nnscr/Mendel90/dibond/sheets/y_carriage.dxf

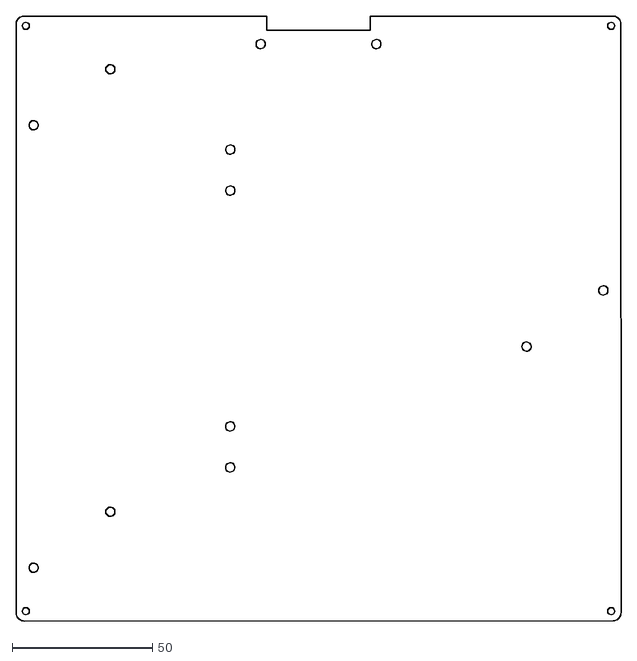
[picture p1: CAD file, 2015-10-09]
dibond/sheets/y_carriage.dxf
216.0 x 216.0
