nnscr/Mendel90/dibond/stls/printed/y_bearing_mounts.stl

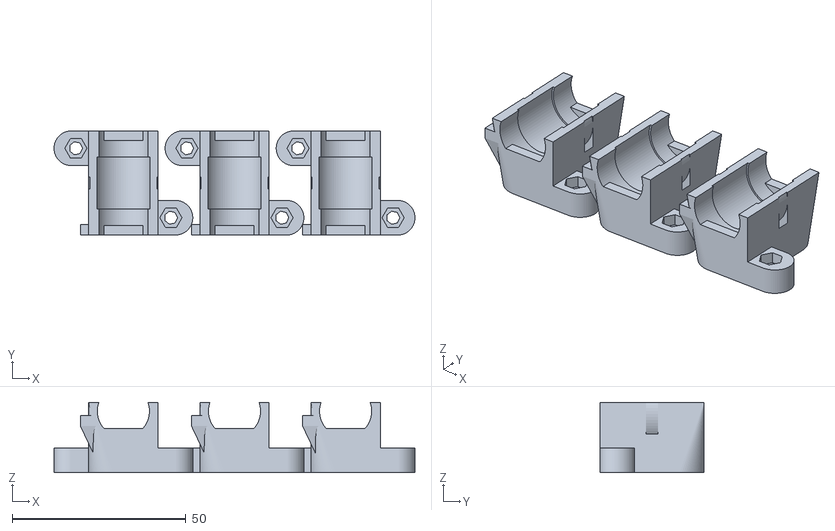
[picture p2: CAD file, 2015-10-09]
dibond/stls/printed/y_bearing_mounts.stl
104.0 x 30.0 x 20.2
