nnscr/Mendel90/dibond/stls/spool_bracket_female.stl

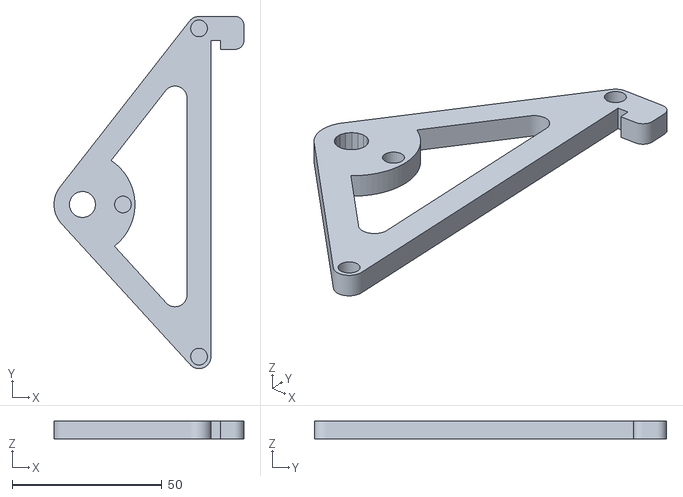
[picture p3: CAD file, 2015-10-09]
dibond/stls/spool_bracket_female.stl
63.4 x 117.5 x 6.00
