nnscr/Mendel90/imported_stls/E3D_v6_1.75mm_Universal.stl

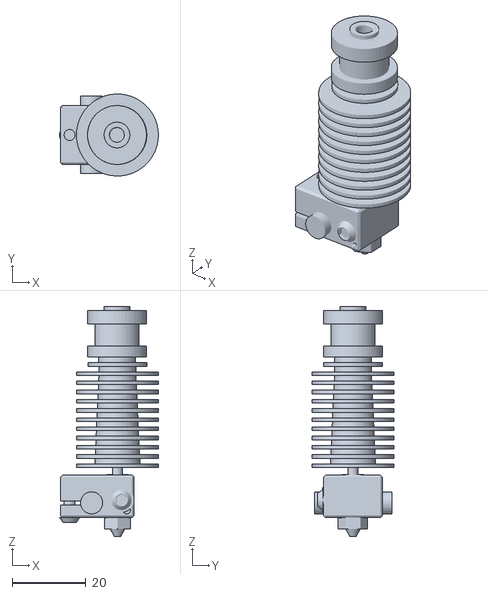
[picture p4: CAD file, 2015-10-11]
imported_stls/E3D_v6_1.75mm_Universal.stl
26.9 x 22.3 x 62.5
