nnscr/Mendel90/mendel/stls/printed/x_carriage_parts.stl

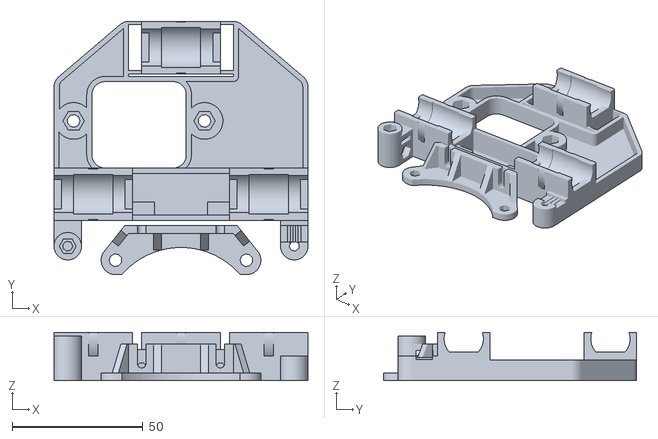
[picture p5: CAD file, 2015-10-09]
mendel/stls/printed/x_carriage_parts.stl
97.0 x 96.7 x 18.5
