nnscr/Mendel90/mendel/stls/ribbon_clamp_14_33NB.stl

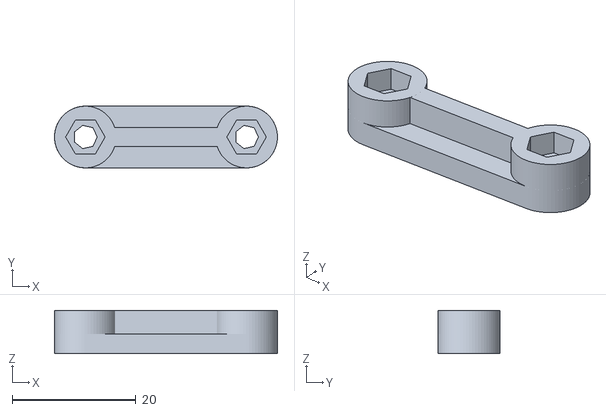
[picture p6: CAD file, 2015-10-09]
mendel/stls/ribbon_clamp_14_33NB.stl
36.1 x 10.00 x 7.01
