nnscr/Mendel90/nnscr/#frame_stays.dxf

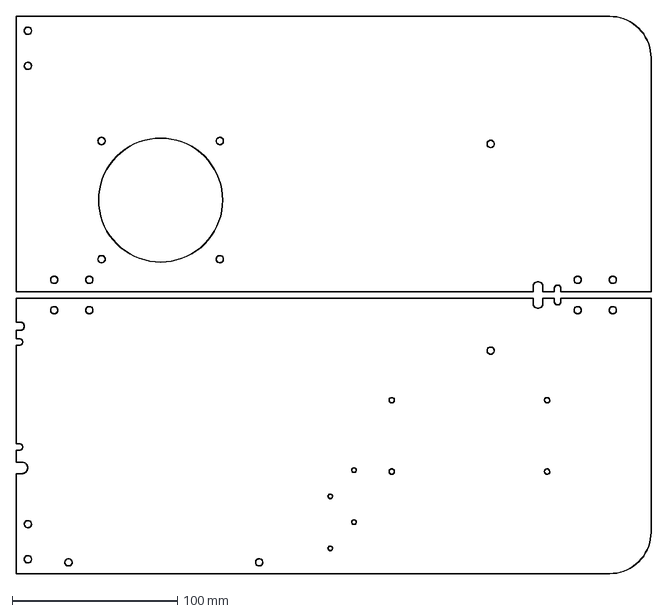
[picture p7: CAD file, 2015-10-09]
nnscr/#frame_stays.dxf
384.0 x 337.0 mm
