nnscr/Mendel90/nnscr/sheets/frame_gantry_and_y_carriage.dxf

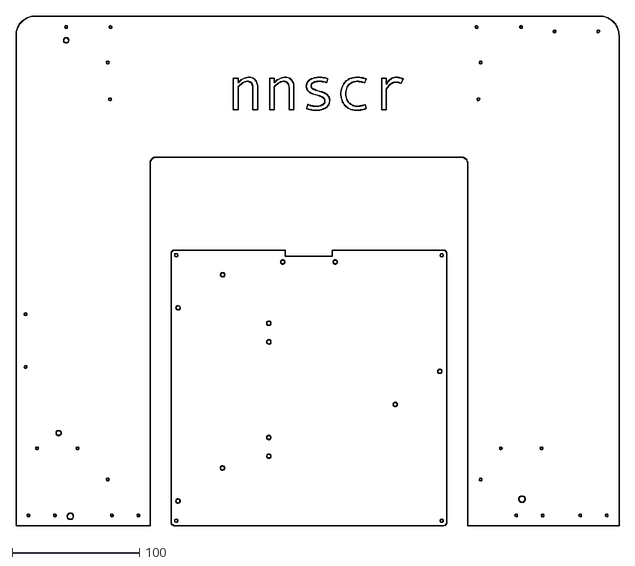
[picture p8: CAD file, 2015-10-26]
nnscr/sheets/frame_gantry_and_y_carriage.dxf
474.5 x 401.0
