nnscr/Mendel90/nnscr/stls/atx_short_bracket.stl

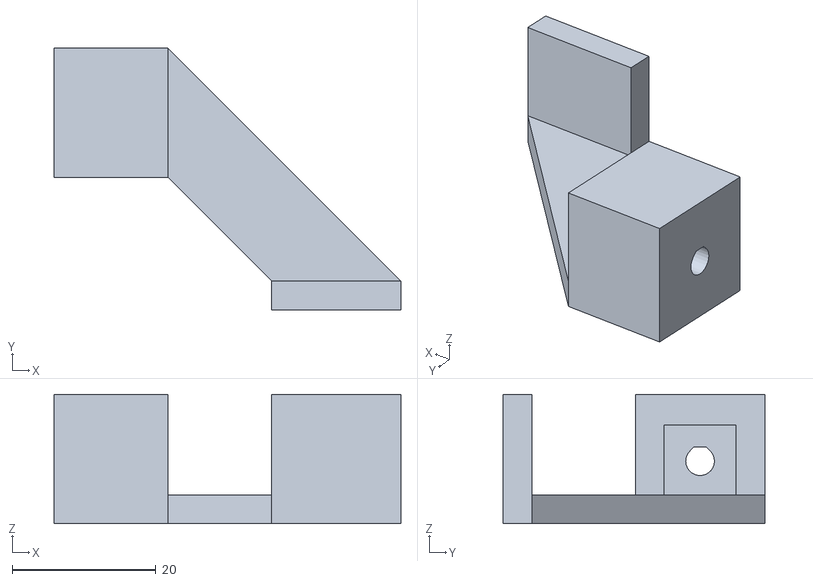
[picture p9: CAD file, 2015-10-26]
nnscr/stls/atx_short_bracket.stl
48.3 x 36.4 x 18.0
