nnscr/Mendel90/nnscr/stls/printed/wades_extruder.stl

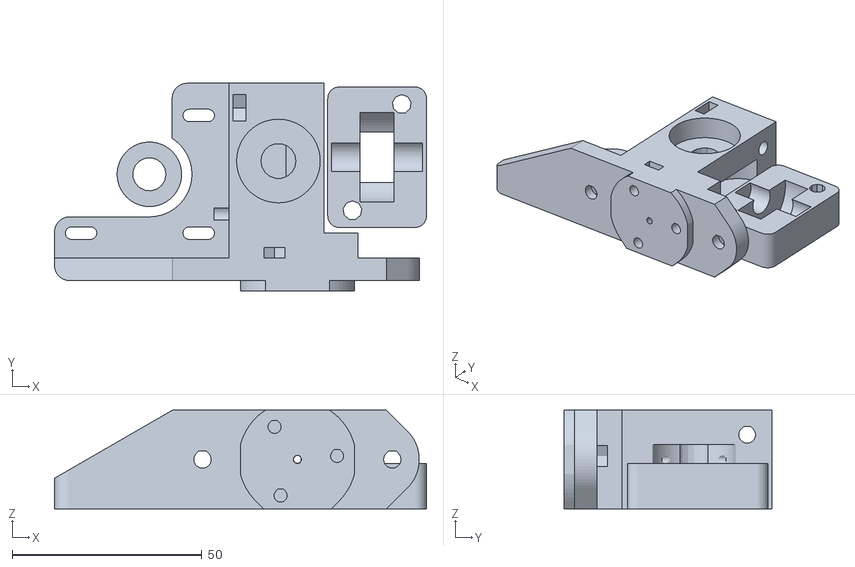
[picture p10: CAD file, 2015-10-26]
nnscr/stls/printed/wades_extruder.stl
98.0 x 54.7 x 26.0
