nnscr/Mendel90/dibond/sheets/y_heatshield.dxf

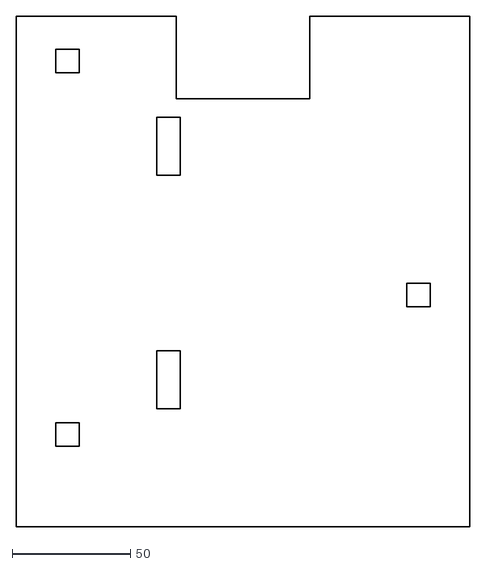
[picture p11: CAD file, 2015-10-09]
dibond/sheets/y_heatshield.dxf
192.0 x 216.0
