nnscr/Mendel90/dibond/stls/y_bearing_mount.stl

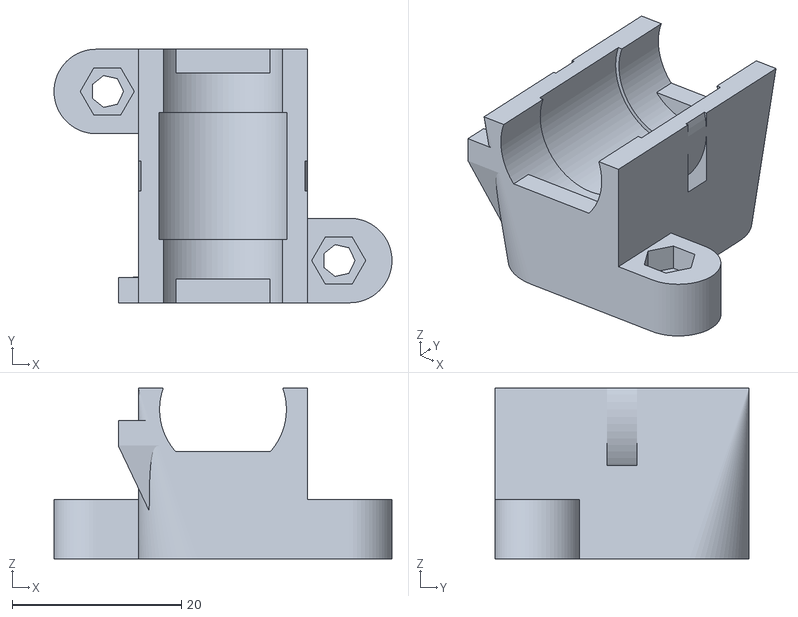
[picture p12: CAD file, 2015-10-09]
dibond/stls/y_bearing_mount.stl
40.0 x 30.0 x 20.2
