nnscr/Mendel90/imported_stls/e3d_v6_fan_duct.stl

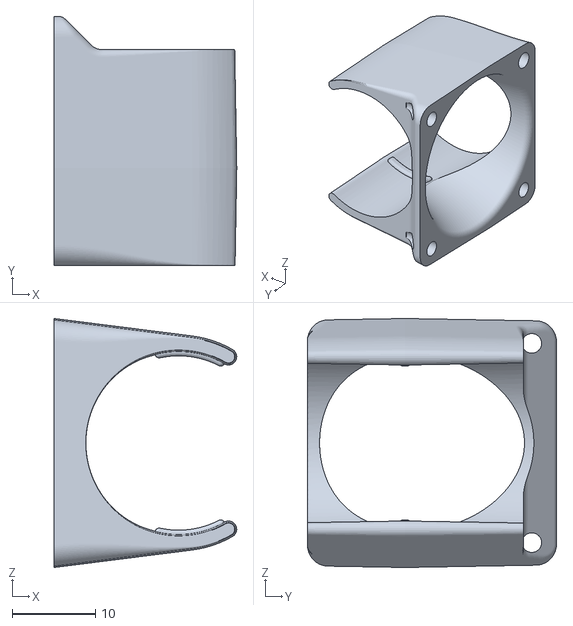
[picture p13: CAD file, 2015-10-09]
imported_stls/e3d_v6_fan_duct.stl
22.0 x 30.0 x 30.0
