nnscr/Mendel90/mendel/stls/d_shell.stl

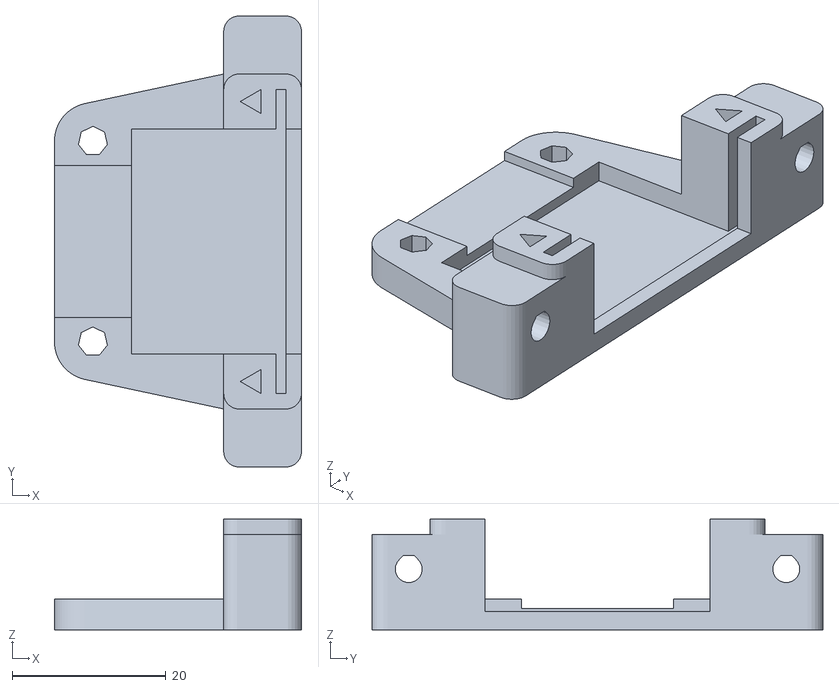
[picture p14: CAD file, 2015-10-09]
mendel/stls/d_shell.stl
32.1 x 58.6 x 14.4
