nnscr/Mendel90/mendel/stls/printed/spool_holder_brackets.stl

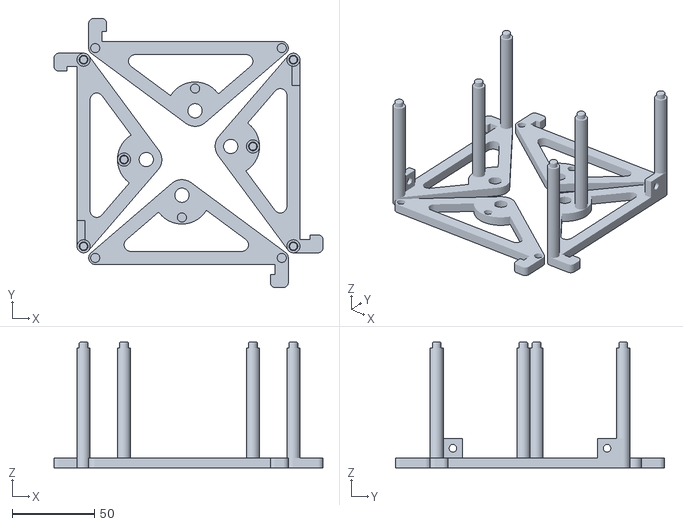
[picture p15: CAD file, 2015-10-09]
mendel/stls/printed/spool_holder_brackets.stl
163.6 x 163.6 x 76.4
