nnscr/Mendel90/nnscr/sheets/frame_stays.dxf

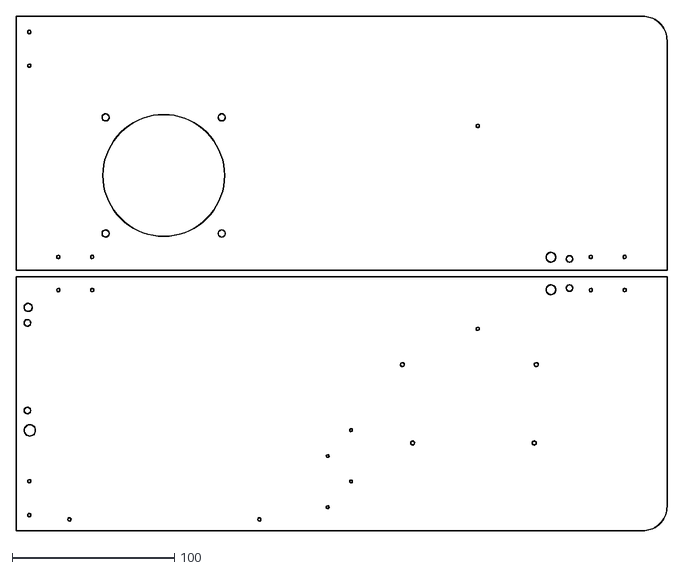
[picture p16: CAD file, 2015-10-26]
nnscr/sheets/frame_stays.dxf
401.0 x 317.0
