nnscr/Mendel90/nnscr/stls/printed/atx_brackets.stl

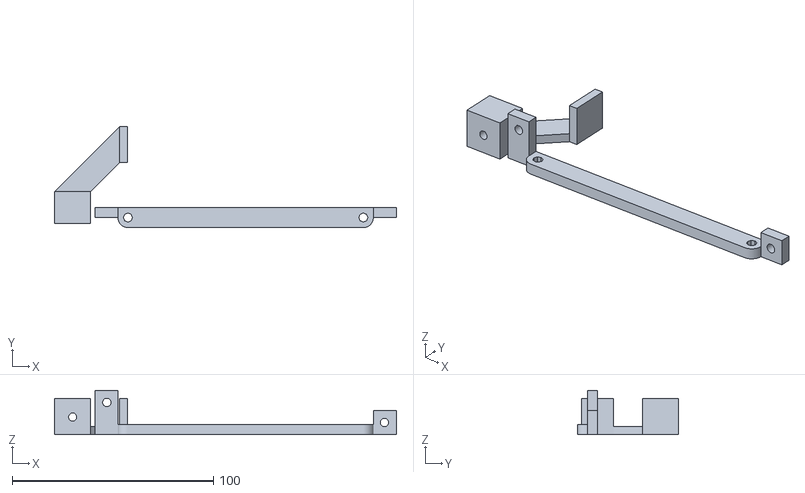
[picture p17: CAD file, 2015-10-26]
nnscr/stls/printed/atx_brackets.stl
170.0 x 50.3 x 22.0
