nnscr/Mendel90/nnscr/stls/wades_block.stl

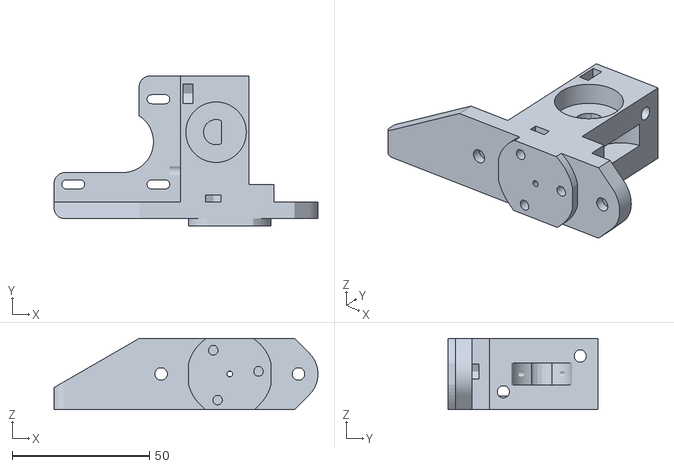
[picture p18: CAD file, 2015-10-26]
nnscr/stls/wades_block.stl
96.1 x 54.7 x 26.0
