nnscr/Mendel90/dibond/sheets/frame_right.dxf

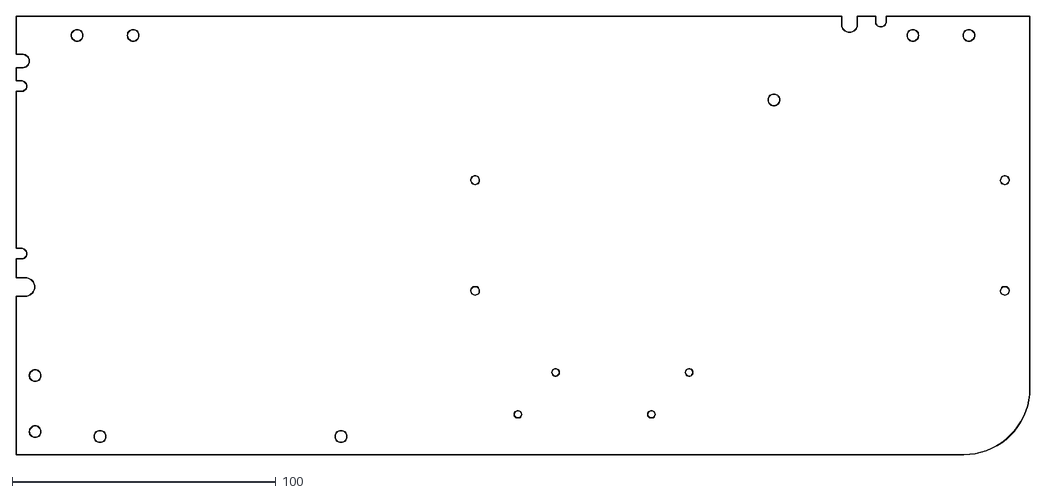
[picture p19: CAD file, 2015-10-09]
dibond/sheets/frame_right.dxf
384.0 x 166.0
