nnscr/Mendel90/dibond/stls/printed/atx_brackets.stl

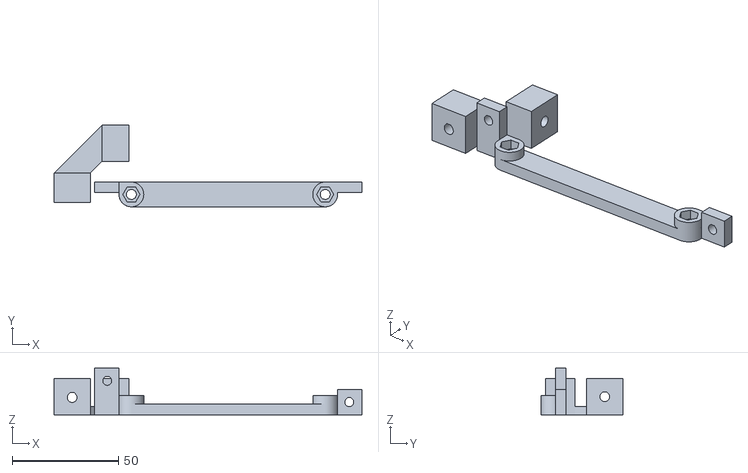
[picture p20: CAD file, 2015-10-09]
dibond/stls/printed/atx_brackets.stl
145.1 x 38.5 x 22.0
