nnscr/Mendel90/mendel/stls/printed/z_motor_brackets.stl

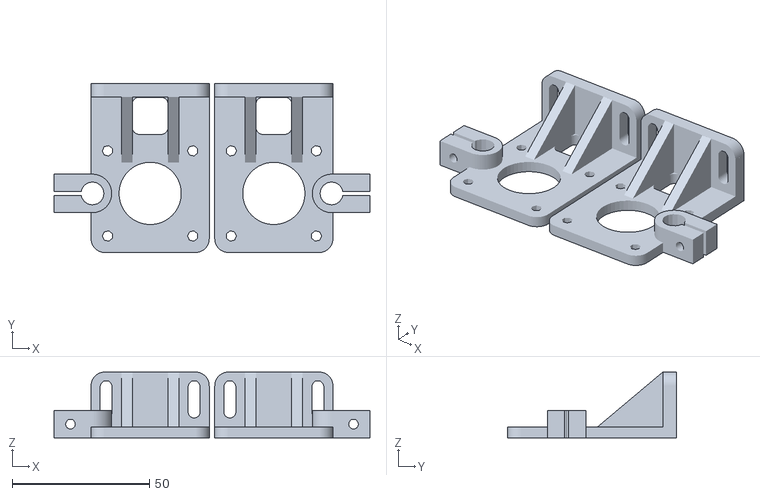
[picture p22: CAD file, 2015-10-09]
mendel/stls/printed/z_motor_brackets.stl
115.0 x 61.5 x 24.0
