nnscr/Mendel90/mendel/stls/ribbon_clamp_26_44.stl

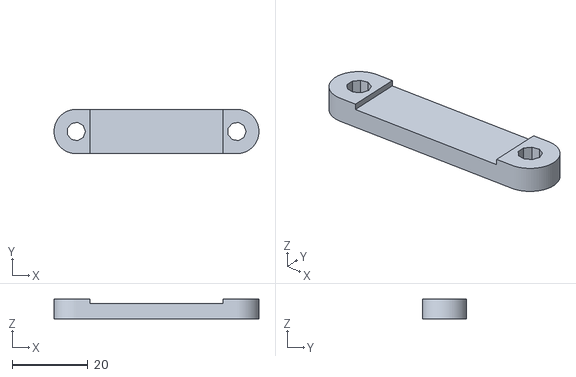
[picture p23: CAD file, 2015-10-09]
mendel/stls/ribbon_clamp_26_44.stl
54.1 x 11.7 x 5.20
