nnscr/Mendel90/nnscr/sheets/frame_base.dxf

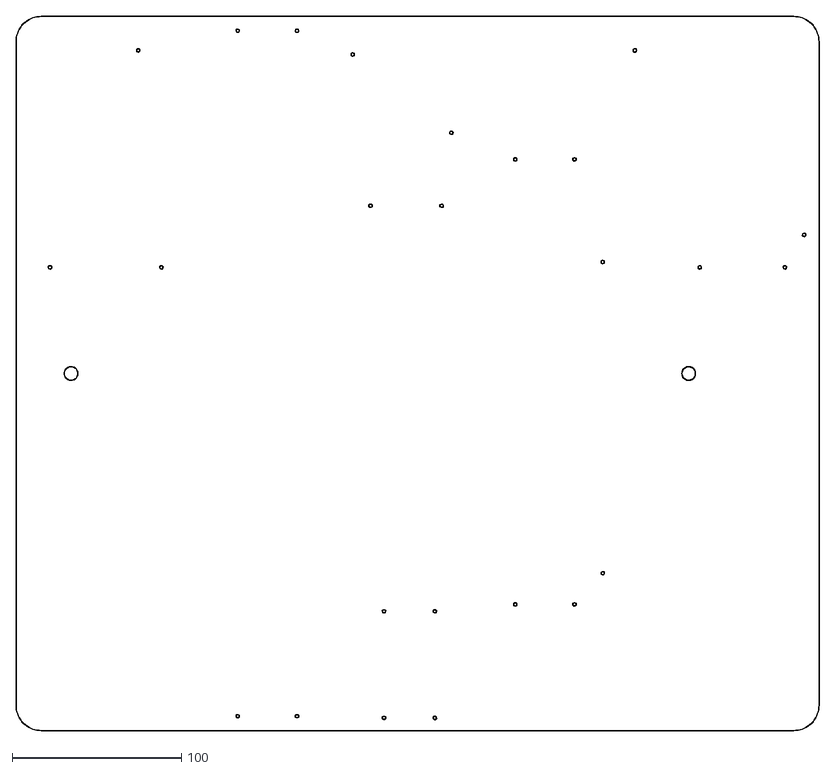
[picture p24: CAD file, 2015-10-26]
nnscr/sheets/frame_base.dxf
474.5 x 422.0
