nnscr/Mendel90/nnscr/stls/printed/spool_holder_brackets.stl

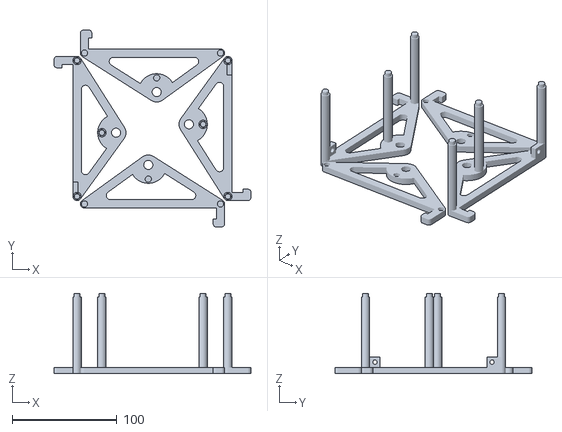
[picture p25: CAD file, 2015-10-26]
nnscr/stls/printed/spool_holder_brackets.stl
187.6 x 187.6 x 76.5
