nnscr/Mendel90/nnscr/stls/y_idler_bracket.stl

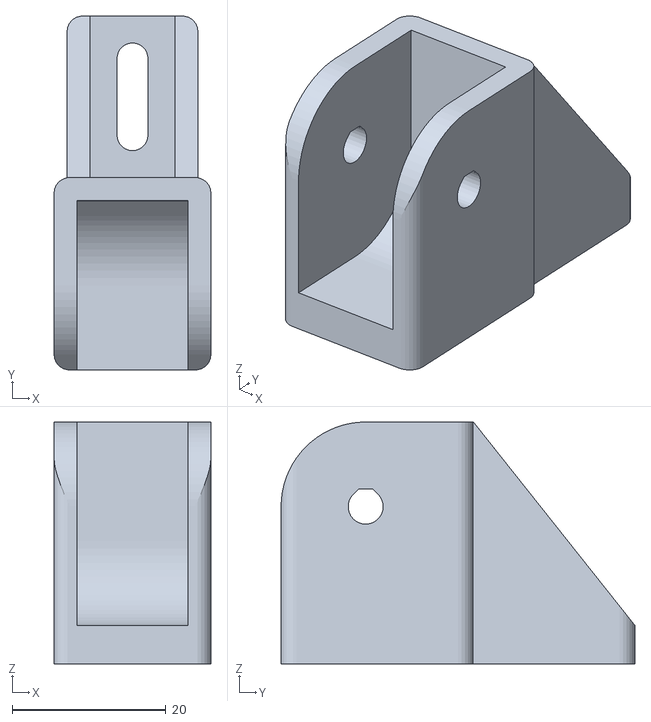
[picture p26: CAD file, 2015-10-19]
nnscr/stls/y_idler_bracket.stl
20.4 x 46.0 x 31.4
