nnscr/Mendel90/dibond/sheets/frame_gantry_and_y_carriage.dxf

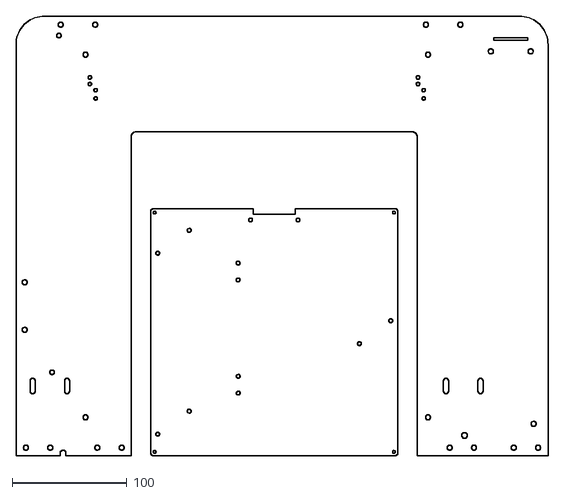
[picture p27: CAD file, 2015-10-09]
dibond/sheets/frame_gantry_and_y_carriage.dxf
464.5 x 384.0
