nnscr/Mendel90/dibond/stls/x_end_clamp.stl

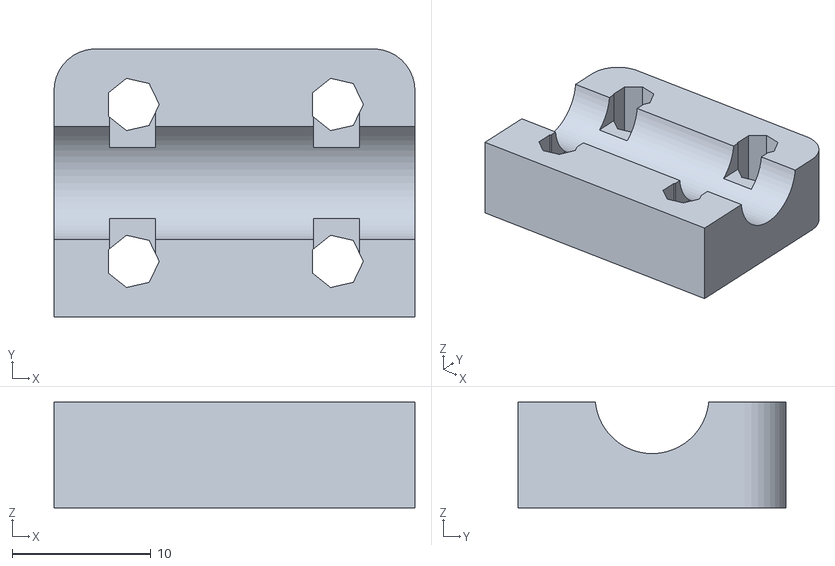
[picture p29: CAD file, 2015-10-09]
dibond/stls/x_end_clamp.stl
26.0 x 19.3 x 7.60
