nnscr/Mendel90/mendel/stls/printed/x_idler_bracket.stl

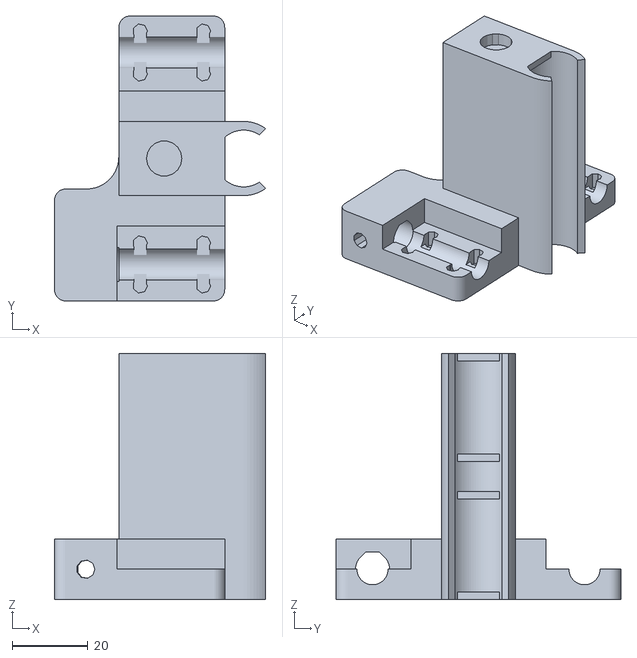
[picture p30: CAD file, 2015-10-09]
mendel/stls/printed/x_idler_bracket.stl
55.8 x 75.3 x 65.0
