nnscr/Mendel90/mendel/stls/y_belt_clip_toothed.stl

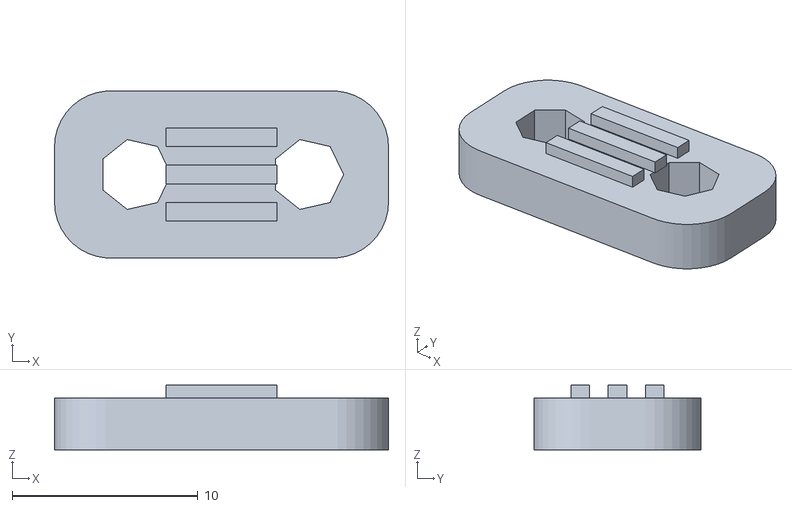
[picture p31: CAD file, 2015-10-09]
mendel/stls/y_belt_clip_toothed.stl
18.0 x 9.00 x 3.48
