nnscr/Mendel90/nnscr/sheets/frame_left.dxf

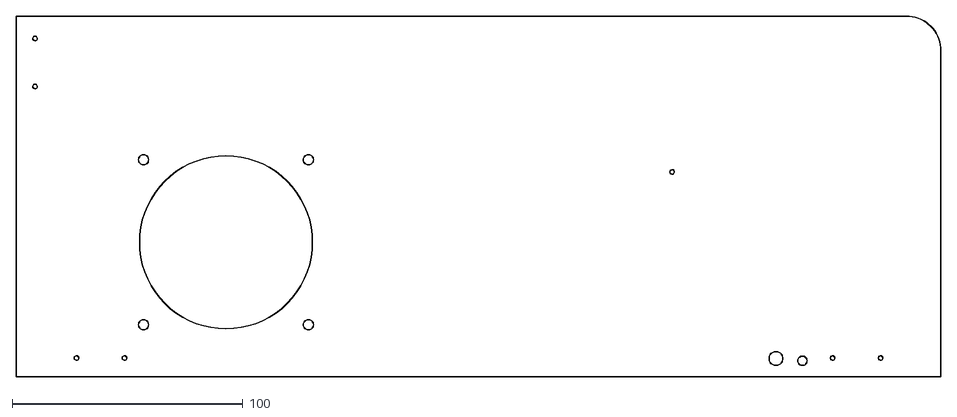
[picture p32: CAD file, 2015-10-26]
nnscr/sheets/frame_left.dxf
401.0 x 156.5
