nnscr/Mendel90/nnscr/stls/printed/cal.stl

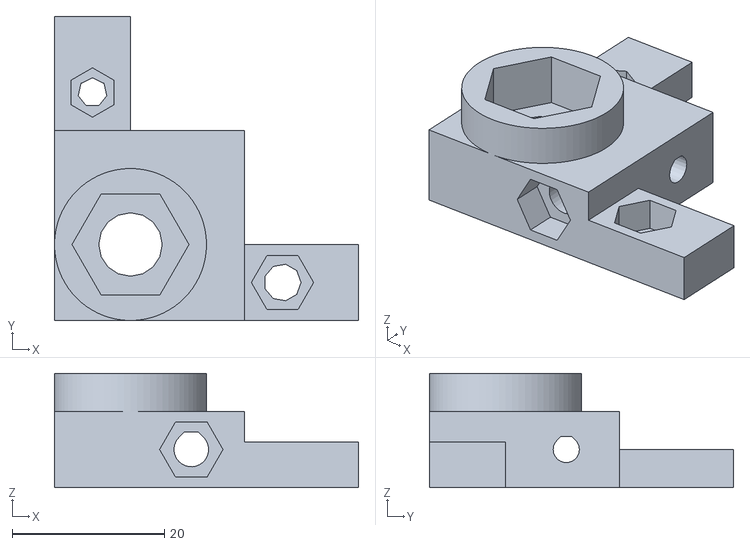
[picture p33: CAD file, 2015-10-19]
nnscr/stls/printed/cal.stl
40.0 x 40.0 x 15.0
