nnscr/Mendel90/nnscr/stls/x_idler_bracket.stl

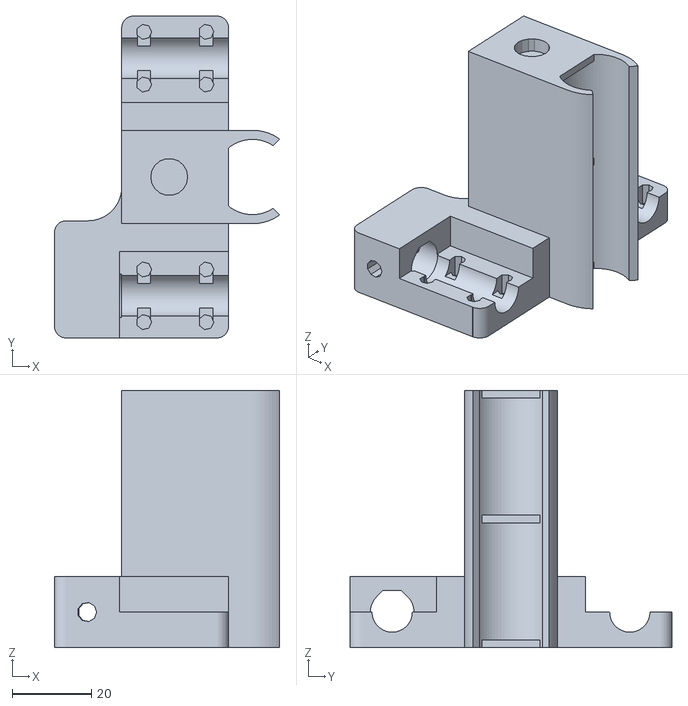
[picture p34: CAD file, 2015-10-19]
nnscr/stls/x_idler_bracket.stl
56.9 x 81.3 x 65.0
