nnscr/Mendel90/dibond/sheets/frame_stays.dxf

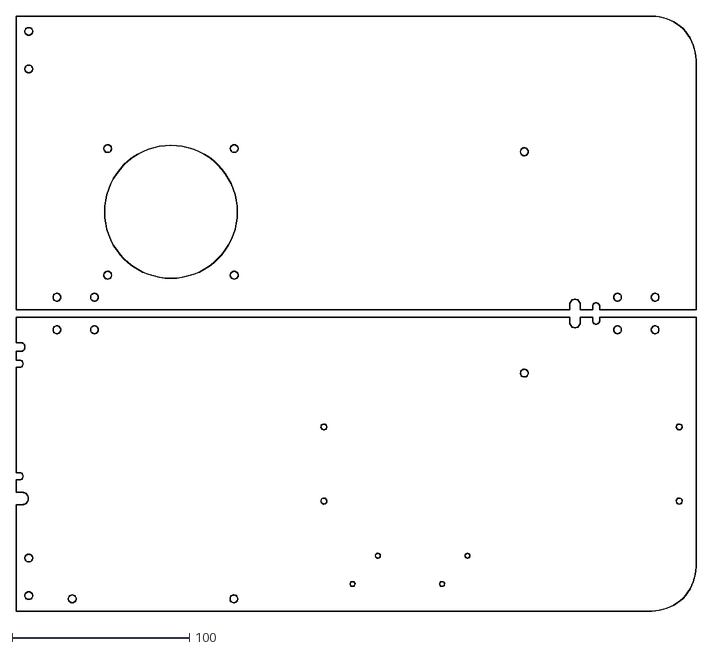
[picture p35: CAD file, 2015-10-09]
dibond/sheets/frame_stays.dxf
384.0 x 336.0
