nnscr/Mendel90/dibond/stls/printed/tube_cap.stl

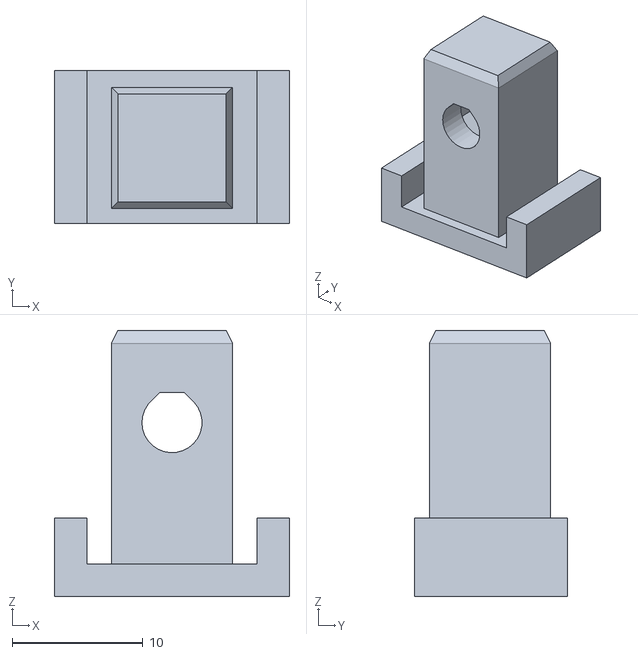
[picture p36: CAD file, 2015-10-09]
dibond/stls/printed/tube_cap.stl
18.0 x 11.7 x 20.4
