nnscr/Mendel90/mendel/stls/printed/x_end_clamp.stl

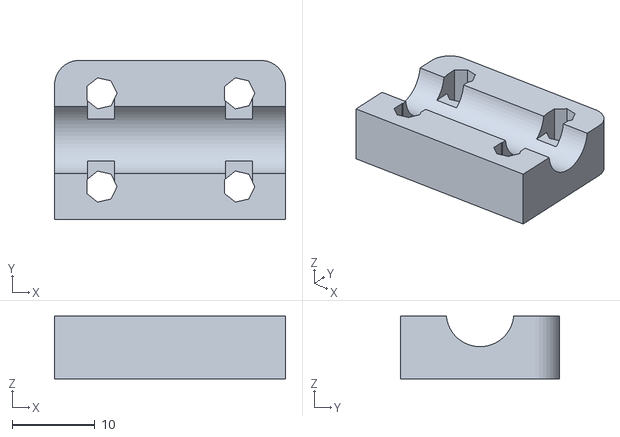
[picture p38: CAD file, 2015-10-09]
mendel/stls/printed/x_end_clamp.stl
28.0 x 19.3 x 7.60
