nnscr/Mendel90/mendel/stls/wades_big_gear.stl

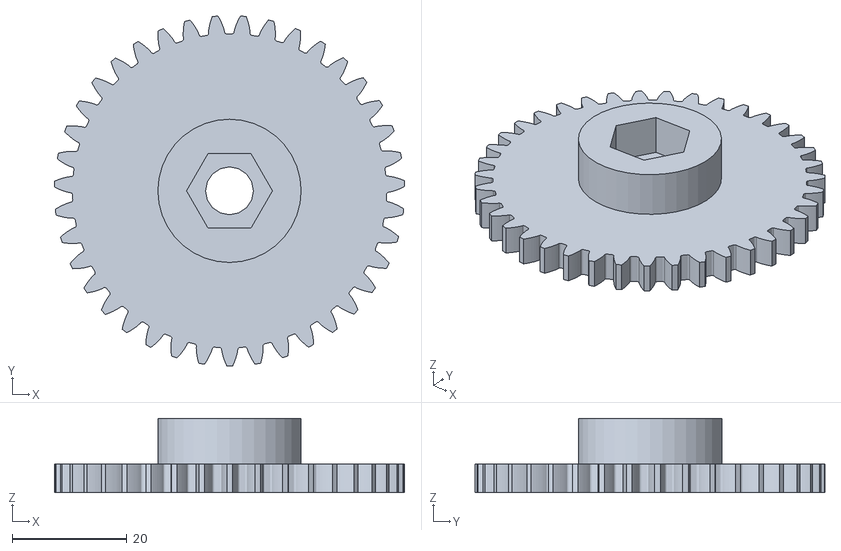
[picture p39: CAD file, 2015-10-09]
mendel/stls/wades_big_gear.stl
61.1 x 61.1 x 13.0
