nnscr/Mendel90/nnscr/sheets/frame_right.dxf

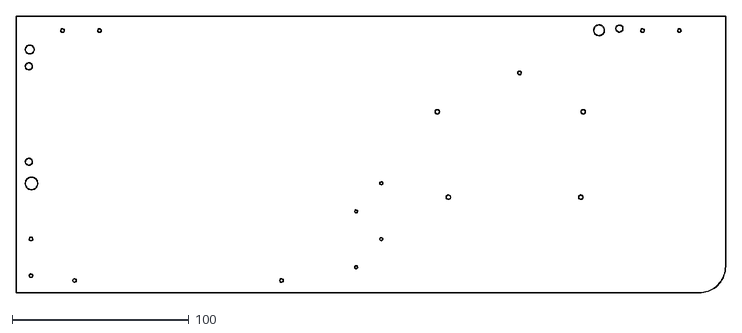
[picture p40: CAD file, 2015-10-26]
nnscr/sheets/frame_right.dxf
401.0 x 156.5
