nnscr/Mendel90/nnscr/stls/printed/small_bits.stl

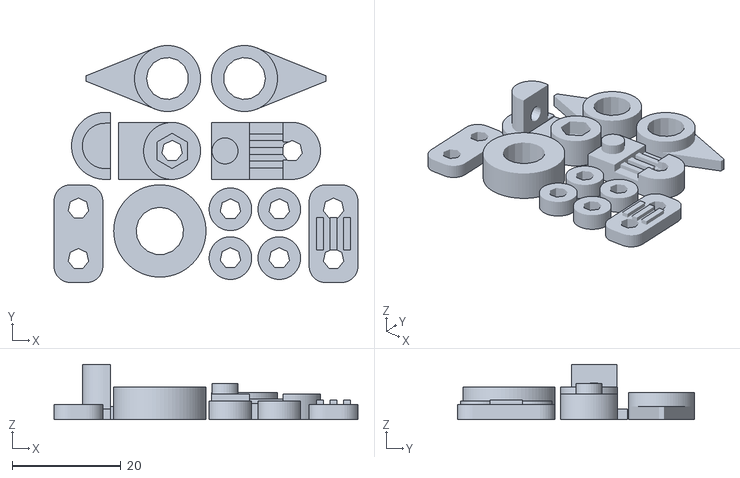
[picture p41: CAD file, 2015-10-19]
nnscr/stls/printed/small_bits.stl
56.0 x 43.7 x 10.2
