nnscr/Mendel90/nnscr/stls/ribbon_clamp_14_33.stl

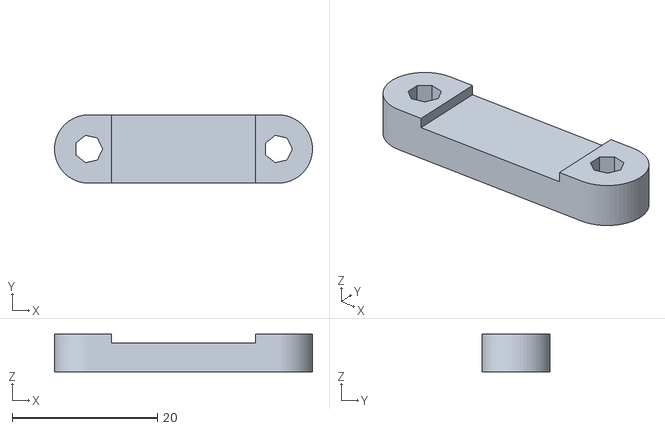
[picture p42: CAD file, 2015-10-19]
nnscr/stls/ribbon_clamp_14_33.stl
35.5 x 9.40 x 5.20
