nnscr/Mendel90/dibond/sheets/frame_left.dxf

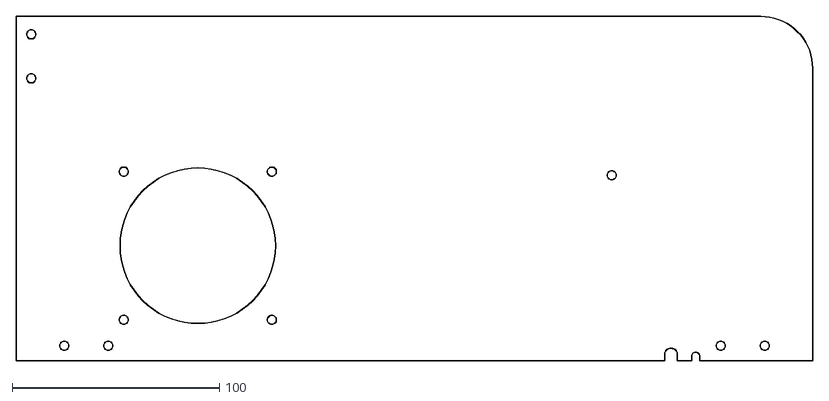
[picture p43: CAD file, 2015-10-09]
dibond/sheets/frame_left.dxf
384.0 x 166.0
