nnscr/Mendel90/dibond/stls/printed/wades_small_gear.stl

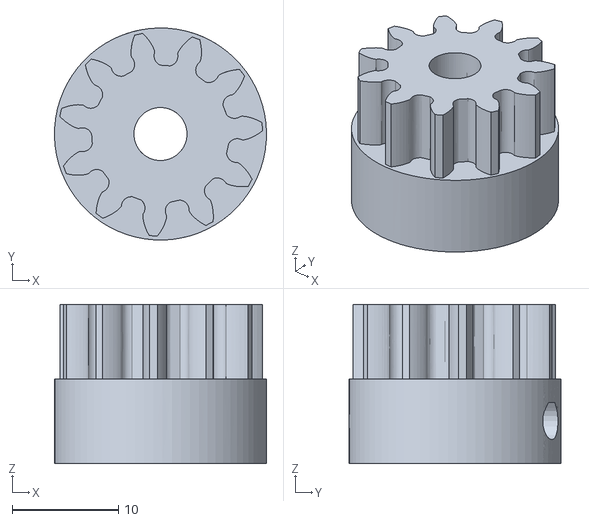
[picture p44: CAD file, 2015-10-09]
dibond/stls/printed/wades_small_gear.stl
20.0 x 20.0 x 15.0
