nnscr/Mendel90/dibond/stls/x_idler_bracket.stl

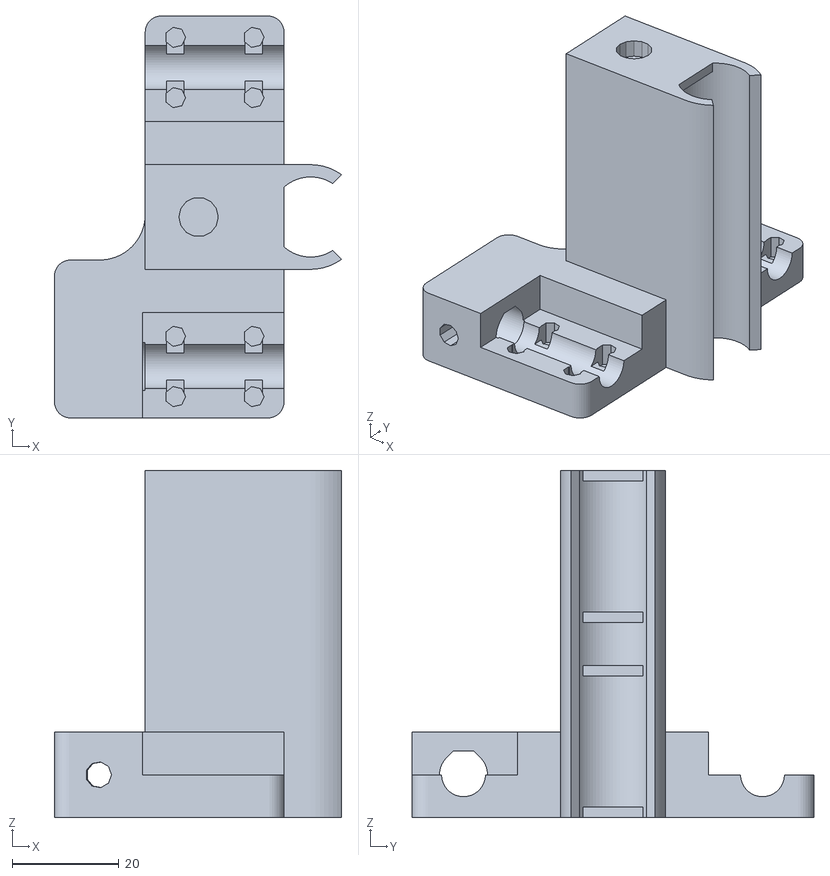
[picture p45: CAD file, 2015-10-09]
dibond/stls/x_idler_bracket.stl
53.8 x 75.3 x 65.0
