nnscr/Mendel90/nnscr/sheets/frame_gantry.dxf

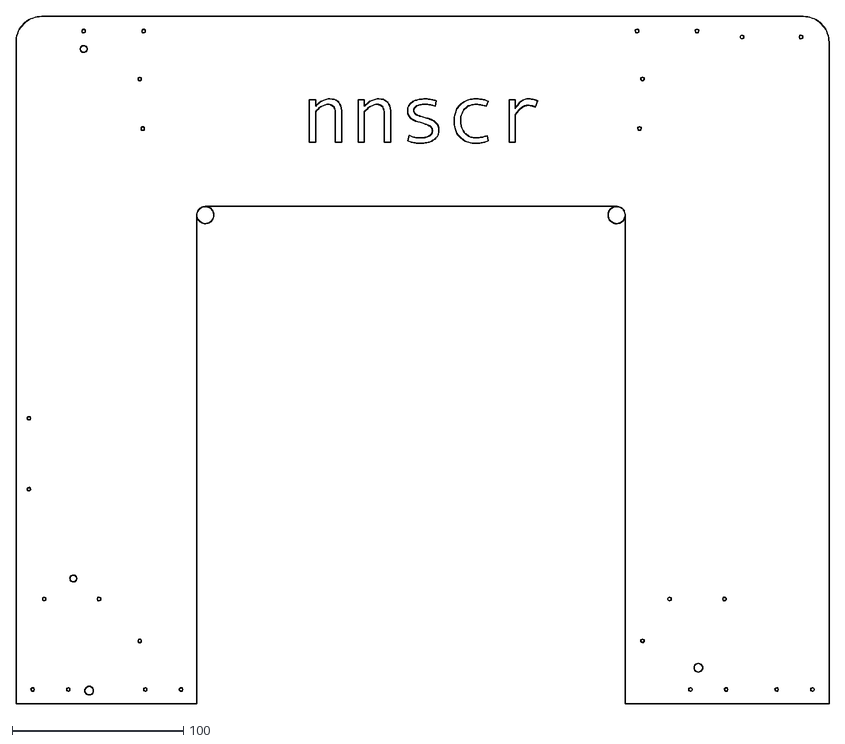
[picture p46: CAD file, 2015-10-26]
nnscr/sheets/frame_gantry.dxf
474.5 x 401.0
