nnscr/Mendel90/nnscr/stls/atx_long_bracket.stl

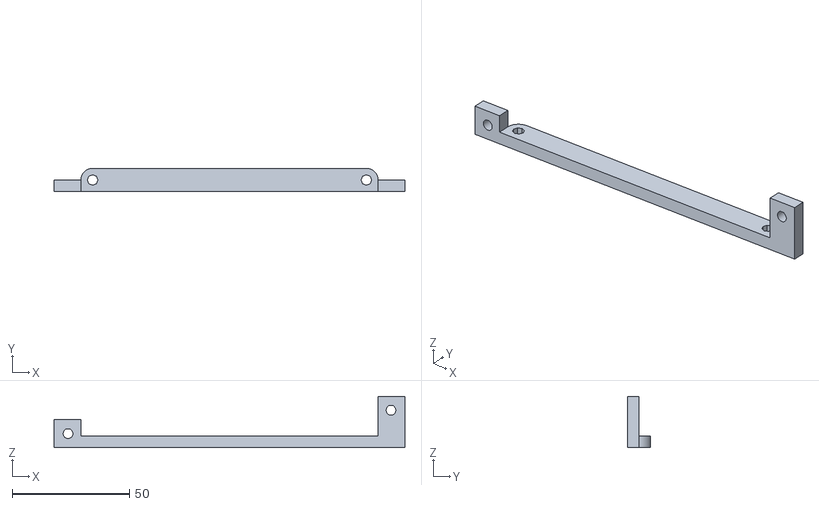
[picture p47: CAD file, 2015-10-19]
nnscr/stls/atx_long_bracket.stl
150.0 x 10.00 x 22.0
