nnscr/Mendel90/nnscr/stls/printed/cable_clips.stl

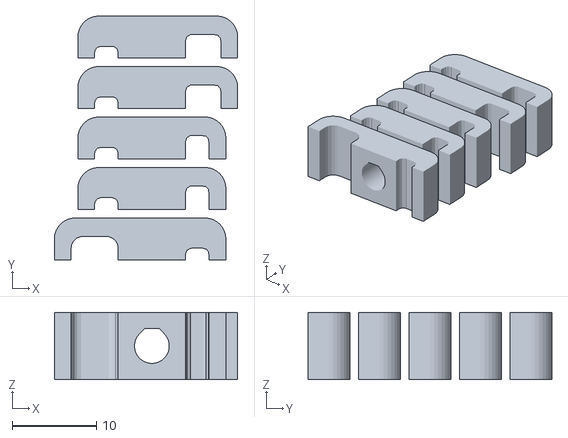
[picture p48: CAD file, 2015-10-19]
nnscr/stls/printed/cable_clips.stl
21.8 x 29.0 x 8.00
