nnscr/Mendel90/dibond/sheets/frame_gantry.dxf

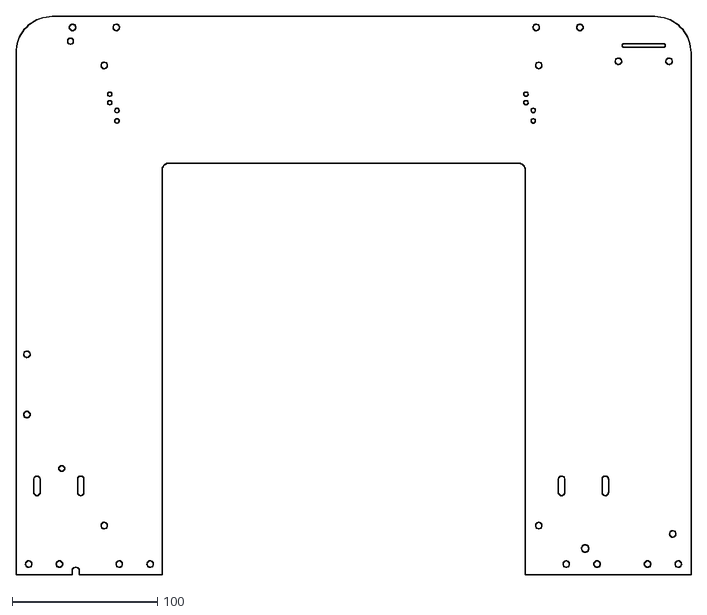
[picture p49: CAD file, 2015-10-09]
dibond/sheets/frame_gantry.dxf
464.5 x 384.0
