nnscr/Mendel90/dibond/stls/printed/z_coupling.stl

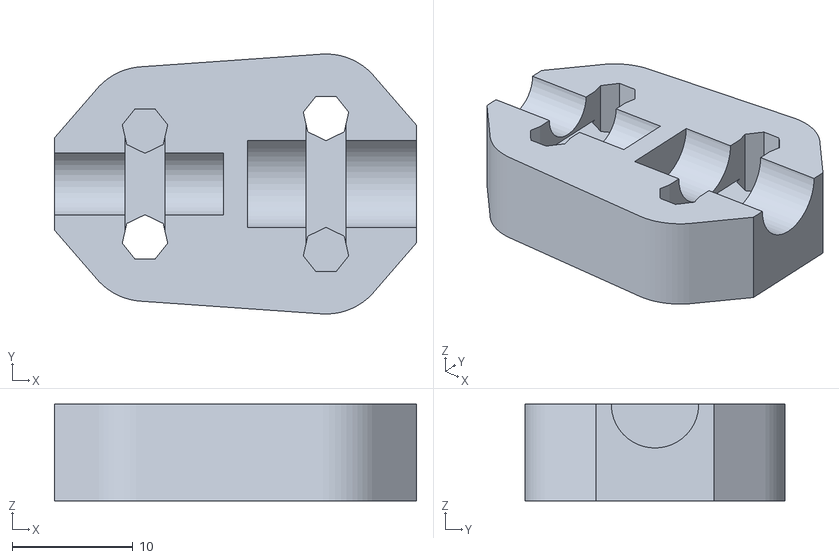
[picture p50: CAD file, 2015-10-09]
dibond/stls/printed/z_coupling.stl
30.0 x 21.5 x 8.00
