nnscr/Mendel90/dibond/stls/x_belt_grip.stl

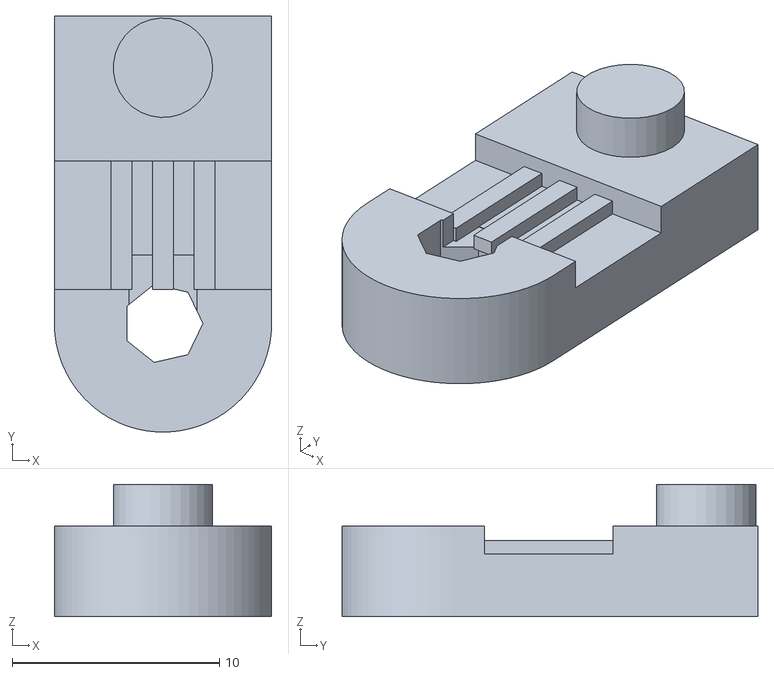
[picture p51: CAD file, 2015-10-09]
dibond/stls/x_belt_grip.stl
10.5 x 20.1 x 6.39
