nnscr/Mendel90/mendel/stls/atx_short_bracket.stl

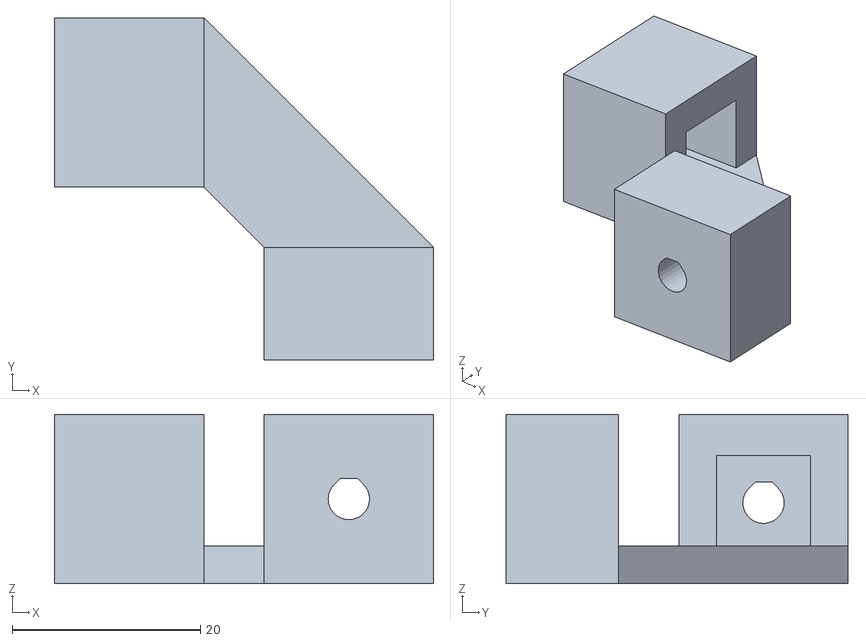
[picture p52: CAD file, 2015-10-09]
mendel/stls/atx_short_bracket.stl
40.3 x 36.4 x 18.0
