nnscr/Mendel90/nnscr/sheets/y_carriage.dxf

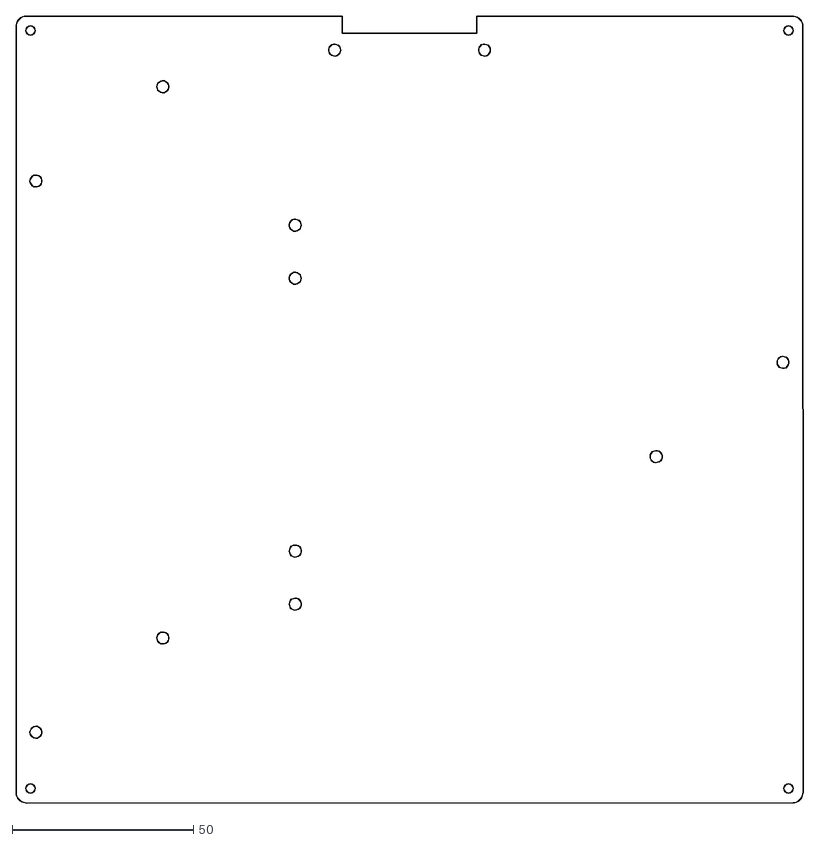
[picture p53: CAD file, 2015-10-19]
nnscr/sheets/y_carriage.dxf
217.0 x 217.0
