nnscr/Mendel90/nnscr/stls/z_motor_bracket_lhs.stl

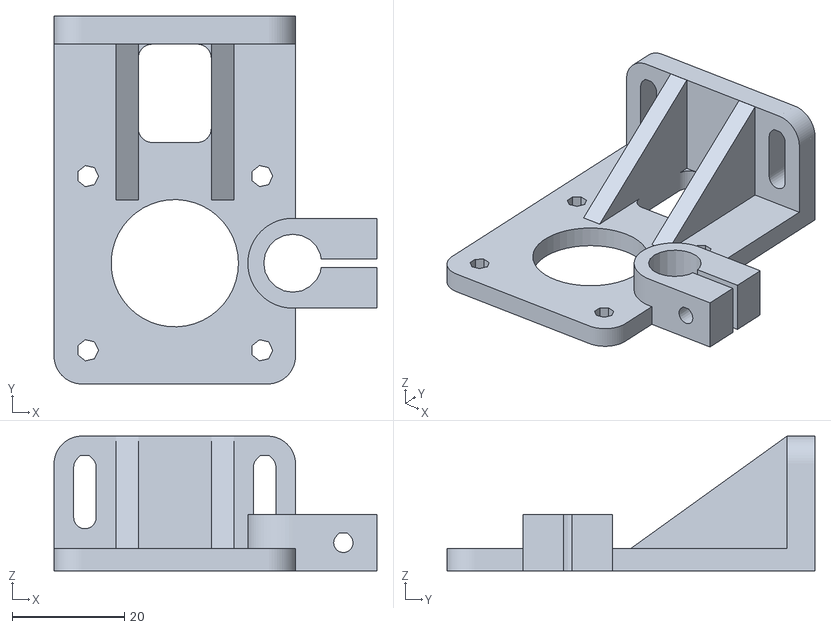
[picture p54: CAD file, 2015-10-19]
nnscr/stls/z_motor_bracket_lhs.stl
57.5 x 65.5 x 24.0
