nnscr/Mendel90/dibond/sheets/frame_base.dxf

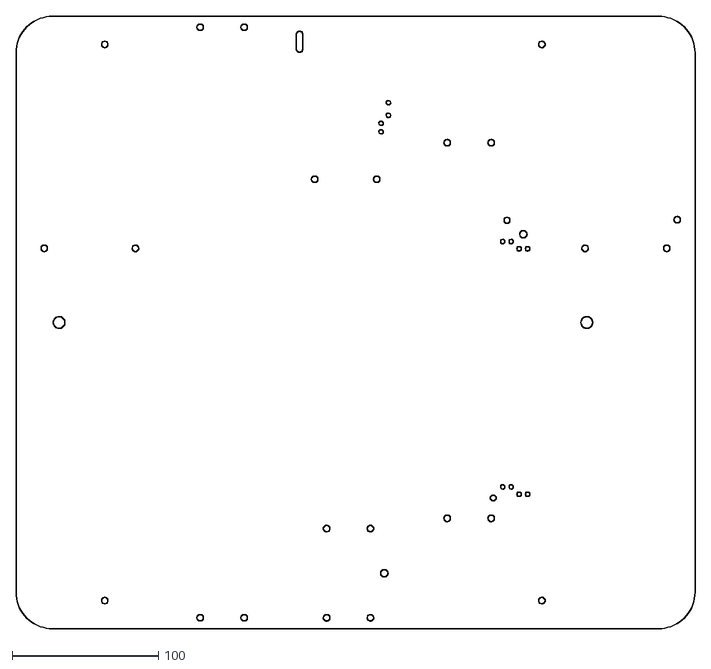
[picture p55: CAD file, 2015-10-09]
dibond/sheets/frame_base.dxf
464.5 x 419.0
