nnscr/Mendel90/dibond/stls/atx_short_bracket.stl

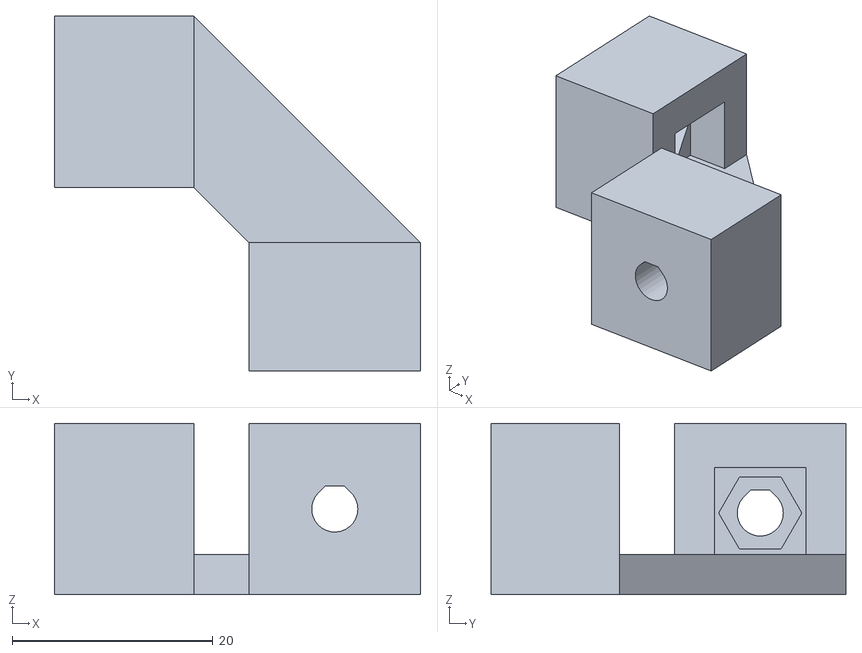
[picture p56: CAD file, 2015-10-09]
dibond/stls/atx_short_bracket.stl
36.5 x 35.4 x 17.1
