nnscr/Mendel90/dibond/stls/printed/spool_holder_brackets.stl

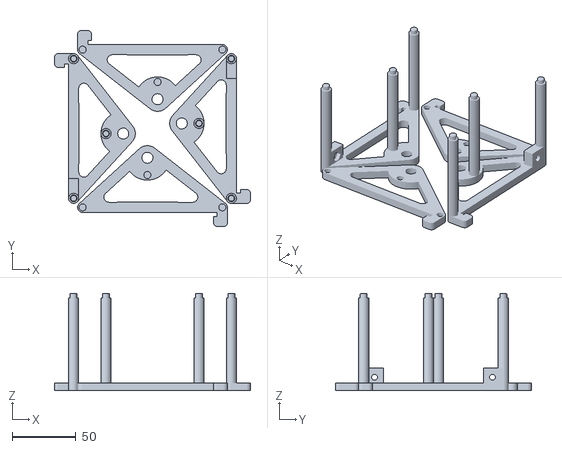
[picture p57: CAD file, 2015-10-09]
dibond/stls/printed/spool_holder_brackets.stl
153.6 x 153.6 x 76.4
