nnscr/Mendel90/mendel/stls/printed/fixing_blocks.stl

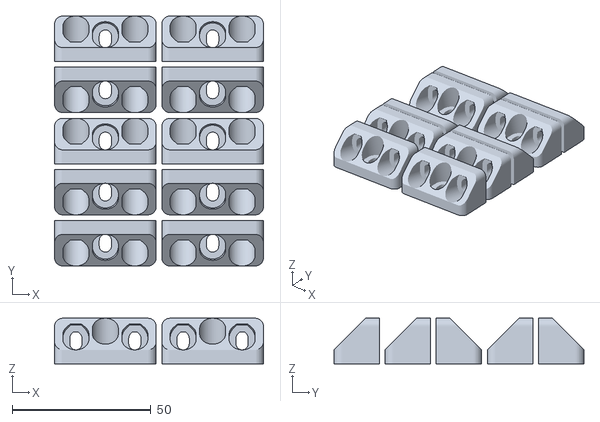
[picture p58: CAD file, 2015-10-09]
mendel/stls/printed/fixing_blocks.stl
75.2 x 90.0 x 16.4
