nnscr/Mendel90/mendel/stls/y_belt_anchor.stl

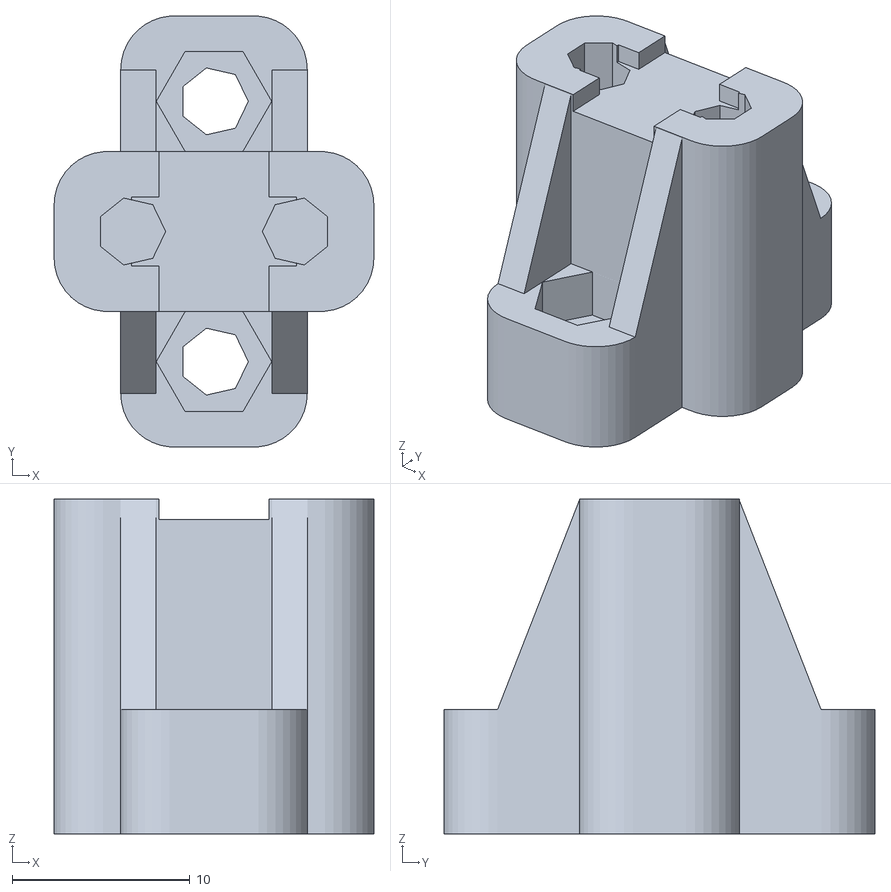
[picture p59: CAD file, 2015-10-09]
mendel/stls/y_belt_anchor.stl
18.0 x 24.3 x 18.9
