nnscr/Mendel90/nnscr/sheets/y_heatshield.dxf

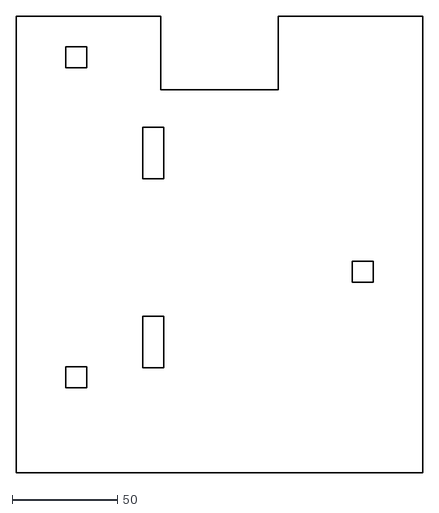
[picture p60: CAD file, 2015-10-19]
nnscr/sheets/y_heatshield.dxf
193.0 x 217.0
