nnscr/Mendel90/nnscr/stls/d_motor_bracket.stl

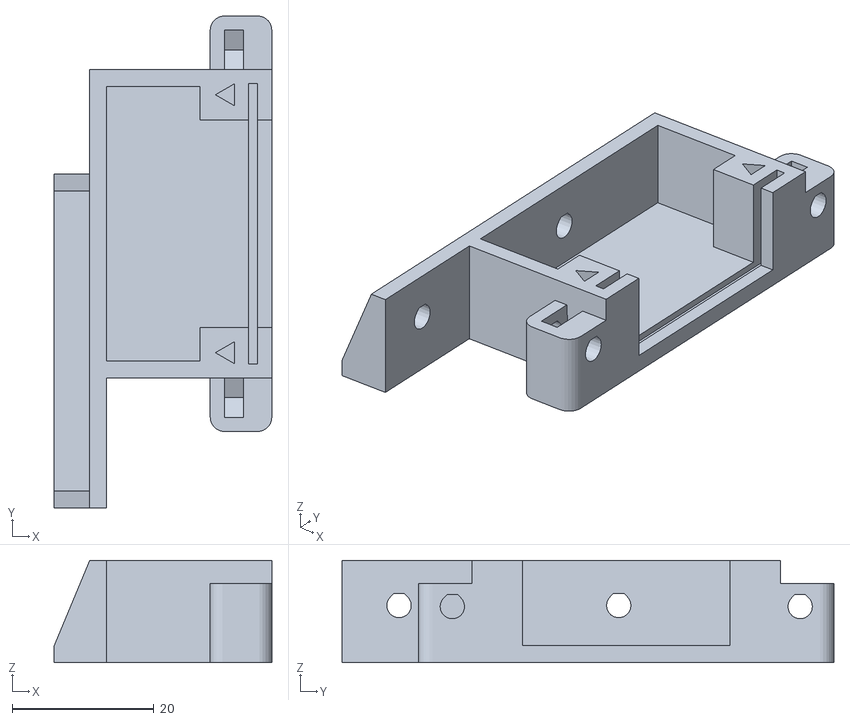
[picture p61: CAD file, 2015-10-19]
nnscr/stls/d_motor_bracket.stl
30.7 x 69.4 x 14.4
