nnscr/Mendel90/nnscr/stls/printed/x_motor_bracket.stl

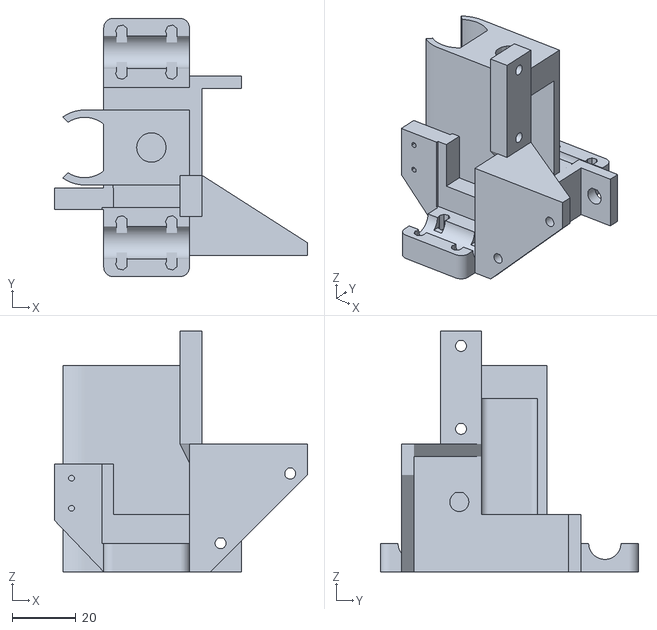
[picture p62: CAD file, 2015-10-19]
nnscr/stls/printed/x_motor_bracket.stl
79.6 x 81.3 x 75.8
