nnscr/Mendel90/dibond/stls/printed/small_bits.stl

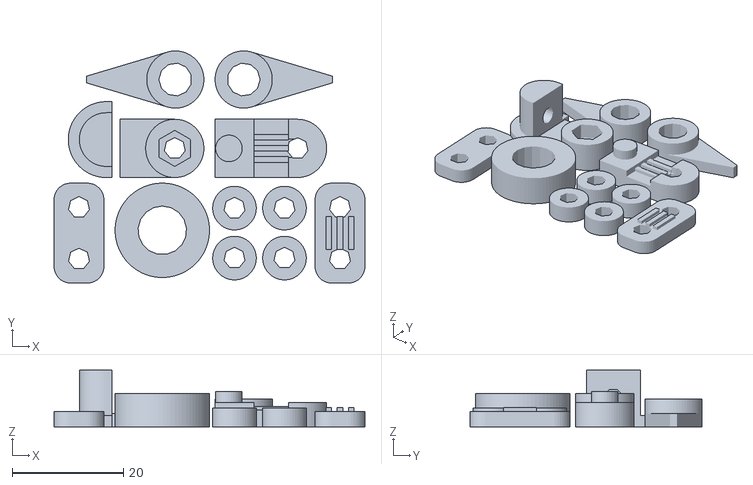
[picture p63: CAD file, 2015-10-09]
dibond/stls/printed/small_bits.stl
56.0 x 41.8 x 10.2
