nnscr/Mendel90/mendel/stls/printed/fan_guard.stl

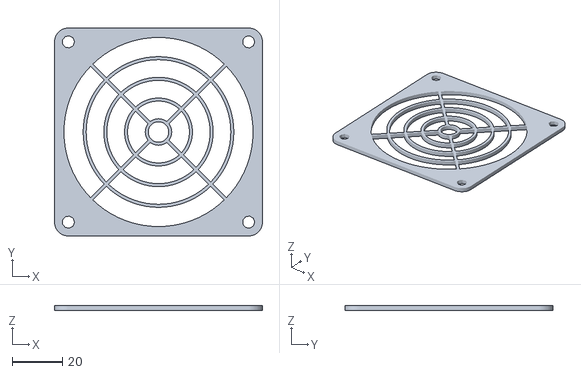
[picture p64: CAD file, 2015-10-09]
mendel/stls/printed/fan_guard.stl
82.5 x 82.5 x 2.00
