nnscr/Mendel90/mendel/stls/wades_idler_block.stl

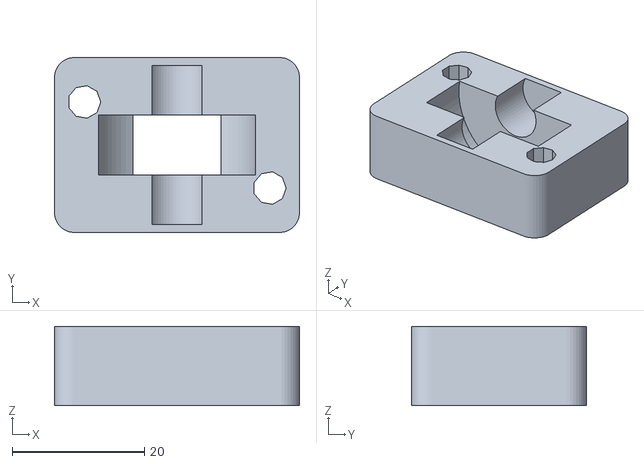
[picture p65: CAD file, 2015-10-09]
mendel/stls/wades_idler_block.stl
37.0 x 26.4 x 12.0
