nnscr/Mendel90/nnscr/stls/printed/z_motor_brackets.stl

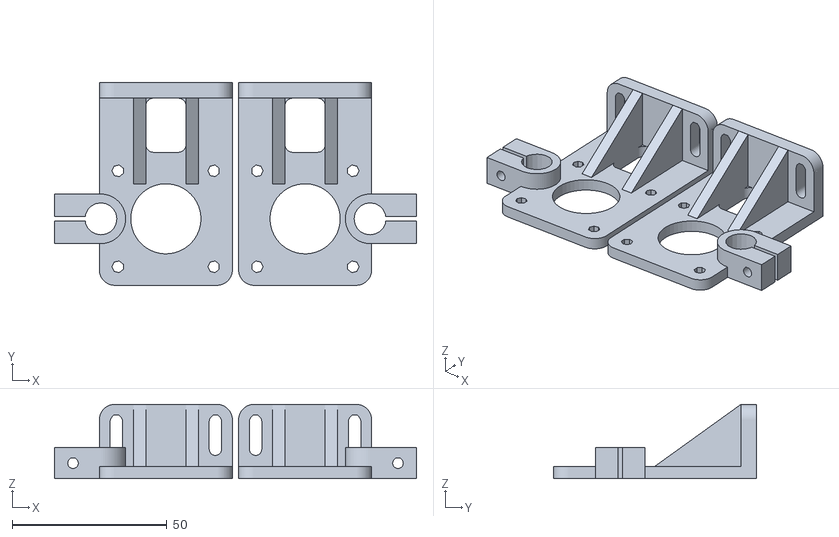
[picture p66: CAD file, 2015-10-19]
nnscr/stls/printed/z_motor_brackets.stl
117.0 x 65.5 x 24.0
