nnscr/Mendel90/nnscr/stls/y_bar_clamp_switch.stl

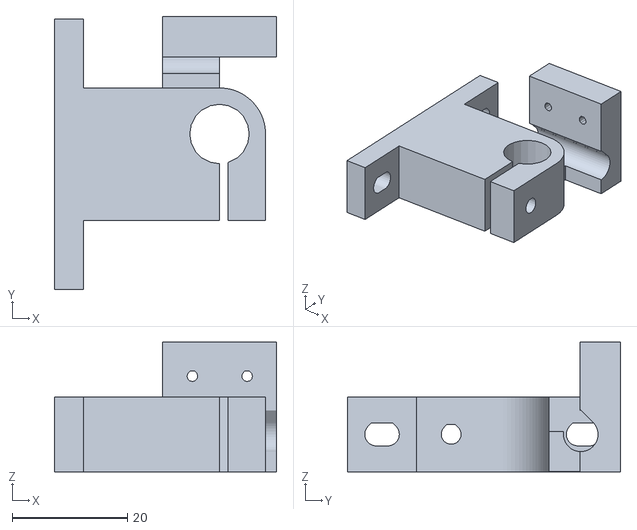
[picture p67: CAD file, 2015-10-19]
nnscr/stls/y_bar_clamp_switch.stl
38.5 x 47.4 x 22.5
