nnscr/Mendel90/dibond/stls/printed/bar_clamps.stl

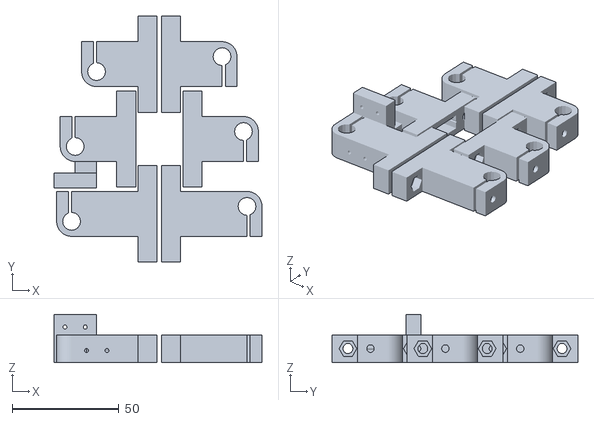
[picture p68: CAD file, 2015-10-09]
dibond/stls/printed/bar_clamps.stl
97.2 x 115.0 x 22.5
