nnscr/Mendel90/dibond/stls/wades_block.stl

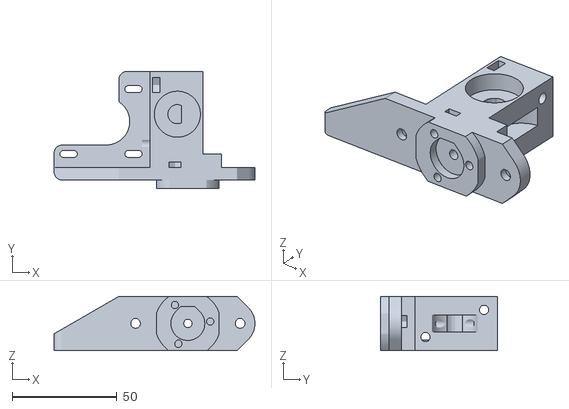
[picture p69: CAD file, 2015-10-09]
dibond/stls/wades_block.stl
96.1 x 56.1 x 26.0
