nnscr/Mendel90/mendel/stls/d_motor_bracket_lid.stl

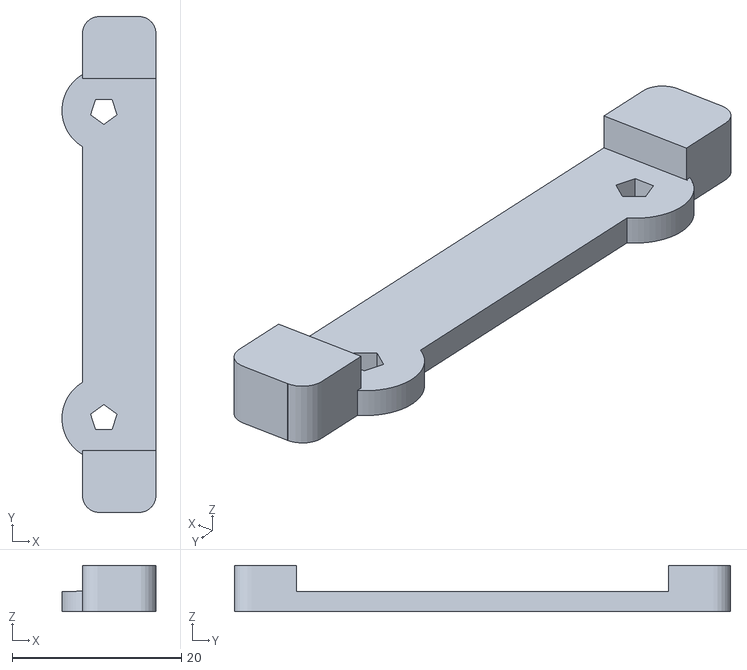
[picture p70: CAD file, 2015-10-09]
mendel/stls/d_motor_bracket_lid.stl
11.1 x 58.6 x 5.45
