nnscr/Mendel90/mendel/stls/printed/x_motor_bracket.stl

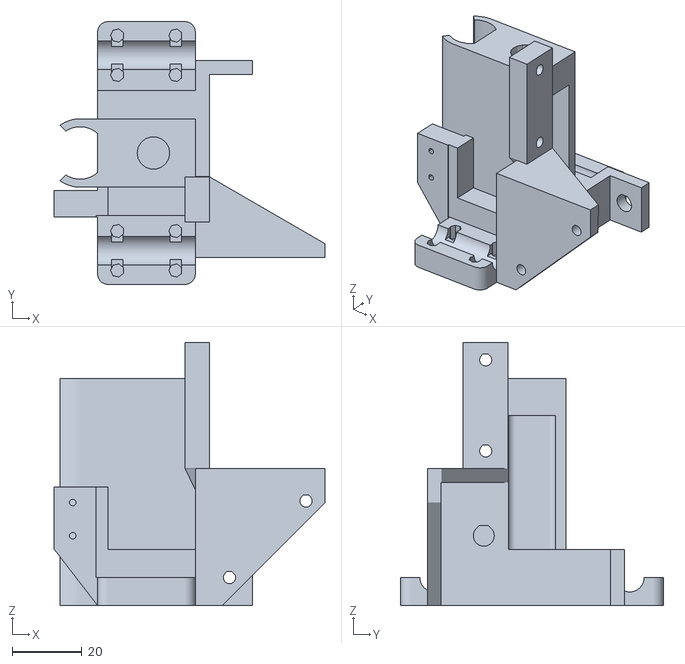
[picture p71: CAD file, 2015-10-09]
mendel/stls/printed/x_motor_bracket.stl
77.6 x 75.3 x 75.4
