nnscr/Mendel90/nnscr/stls/printed/bar_clamps.stl

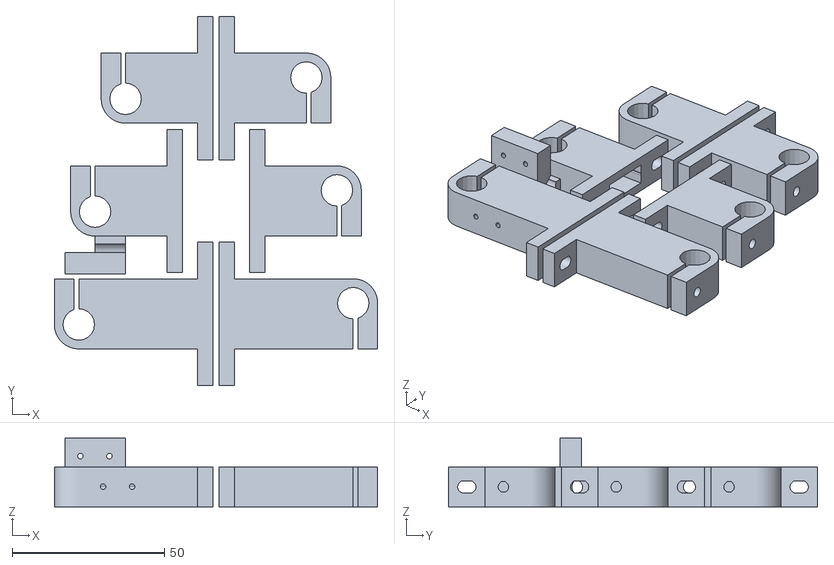
[picture p72: CAD file, 2015-10-19]
nnscr/stls/printed/bar_clamps.stl
106.0 x 121.0 x 22.5
