nnscr/Mendel90/nnscr/stls/x_motor_ribbon_bracket.stl

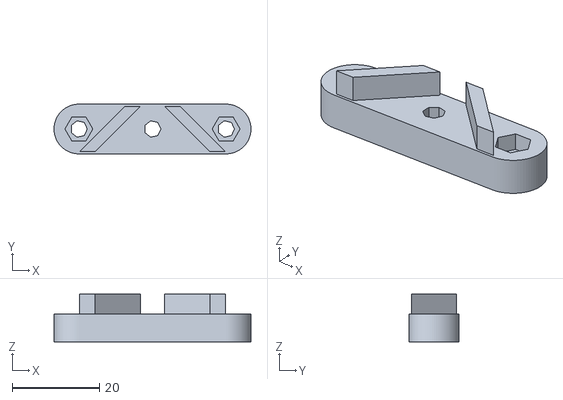
[picture p73: CAD file, 2015-10-19]
nnscr/stls/x_motor_ribbon_bracket.stl
45.1 x 11.4 x 10.9
