nnscr/Mendel90/dibond/stls/printed/y_belt_anchors.stl

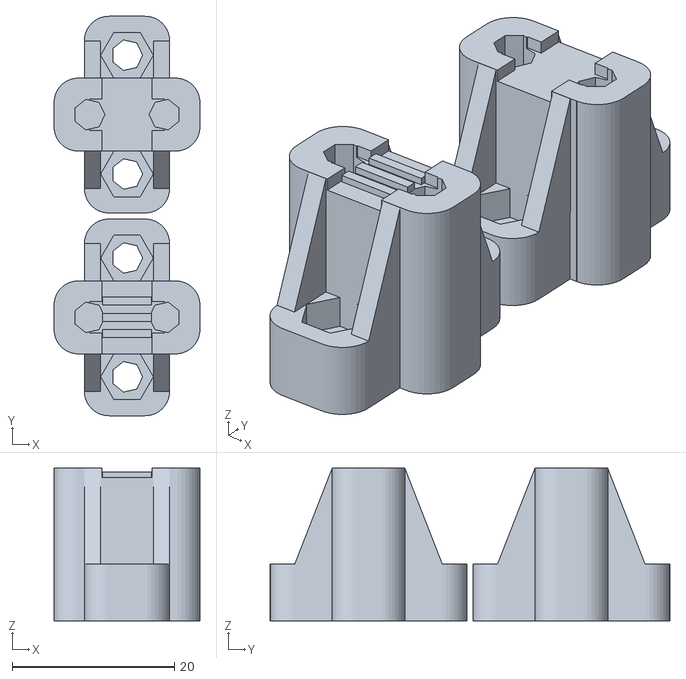
[picture p74: CAD file, 2015-10-09]
dibond/stls/printed/y_belt_anchors.stl
18.0 x 49.3 x 18.9
