nnscr/Mendel90/dibond/stls/y_belt_anchor_toothed.stl

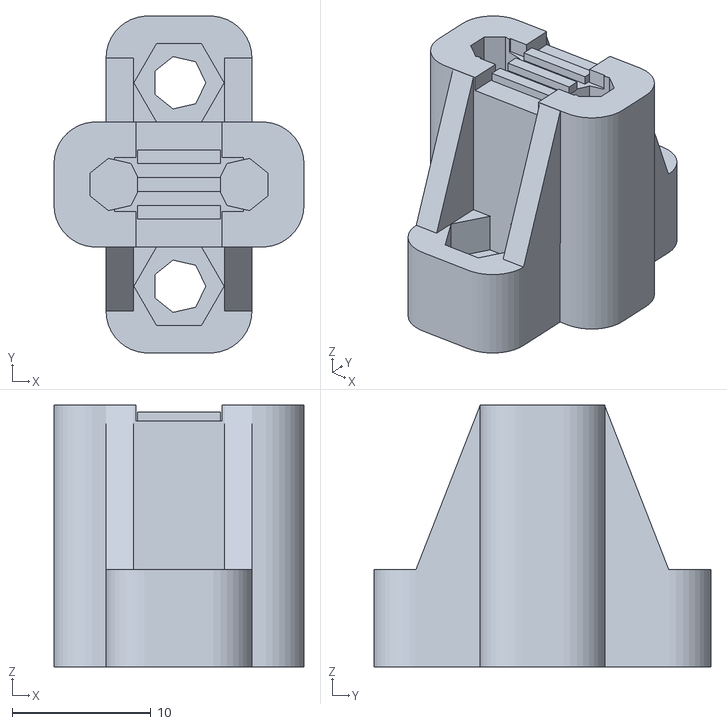
[picture p75: CAD file, 2015-10-09]
dibond/stls/y_belt_anchor_toothed.stl
18.0 x 24.3 x 18.9
