nnscr/Mendel90/mendel/stls/fixing_block.stl

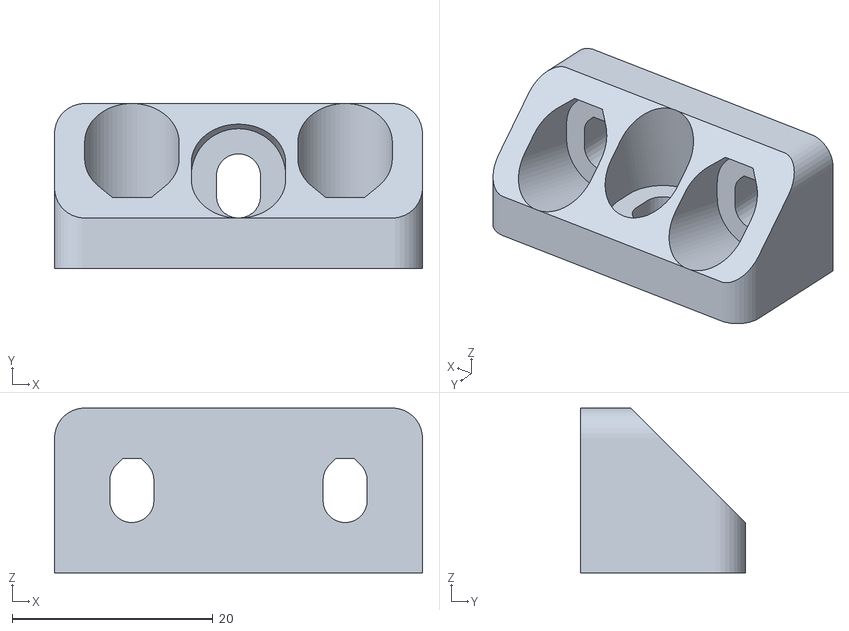
[picture p76: CAD file, 2015-10-09]
mendel/stls/fixing_block.stl
36.6 x 16.4 x 16.4
