nnscr/Mendel90/mendel/stls/printed/ribbon_clamps.stl

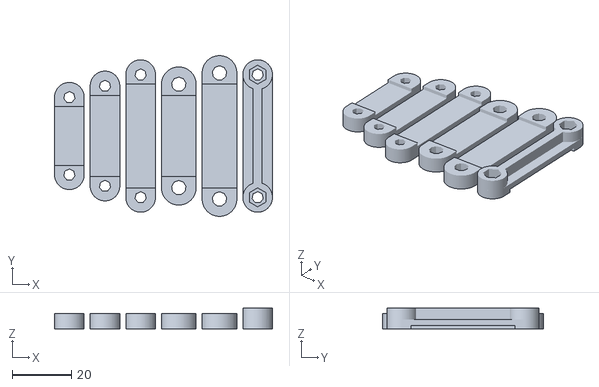
[picture p77: CAD file, 2015-10-09]
mendel/stls/printed/ribbon_clamps.stl
73.4 x 54.1 x 7.01
