nnscr/Mendel90/dibond/stls/dust_filter.stl

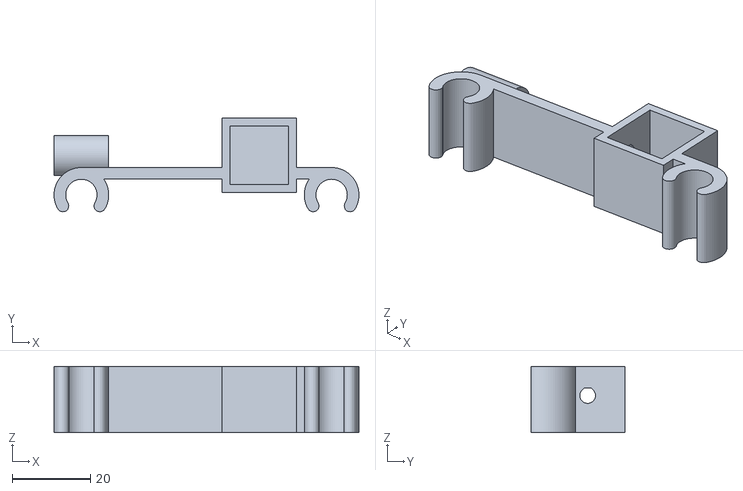
[picture p78: CAD file, 2015-10-09]
dibond/stls/dust_filter.stl
78.0 x 23.9 x 17.0
