nnscr/Mendel90/dibond/stls/printed/y_motor_bracket.stl

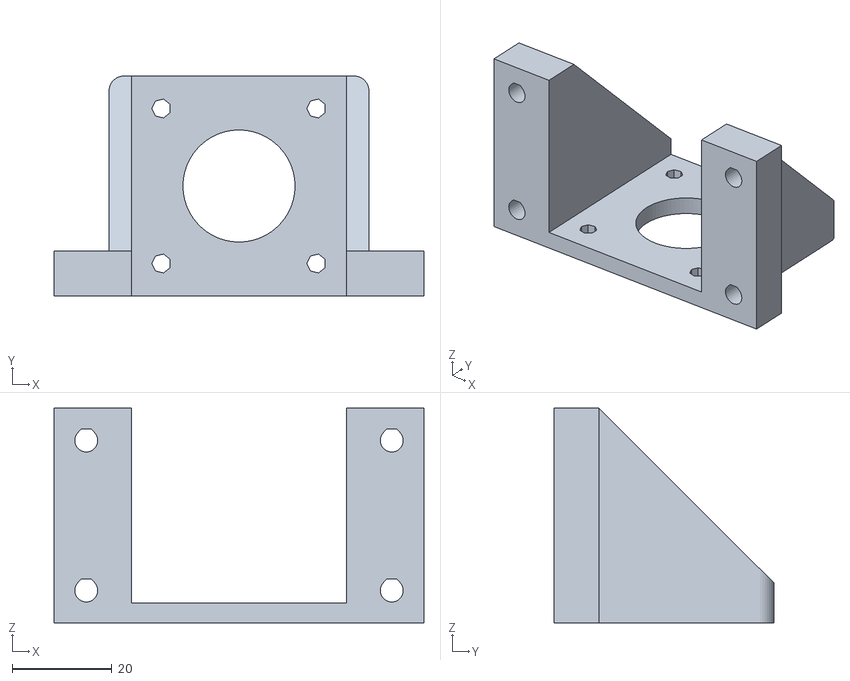
[picture p79: CAD file, 2015-10-09]
dibond/stls/printed/y_motor_bracket.stl
74.0 x 44.0 x 43.0
