nnscr/Mendel90/mendel/stls/printed/y_motor_bracket.stl

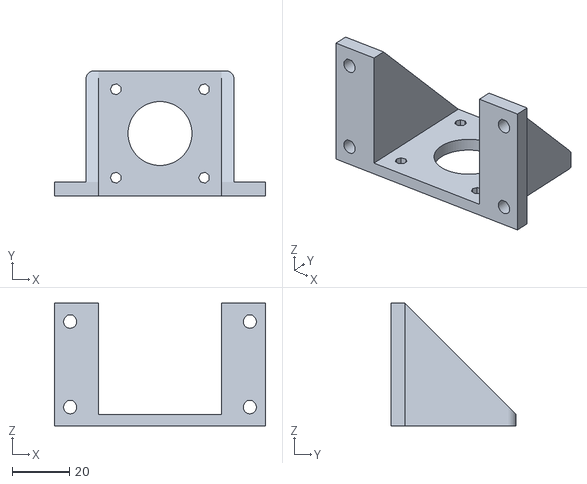
[picture p80: CAD file, 2015-10-09]
mendel/stls/printed/y_motor_bracket.stl
74.0 x 44.0 x 43.0
