nnscr/Mendel90/mendel/stls/ribbon_clamp_20_44.stl

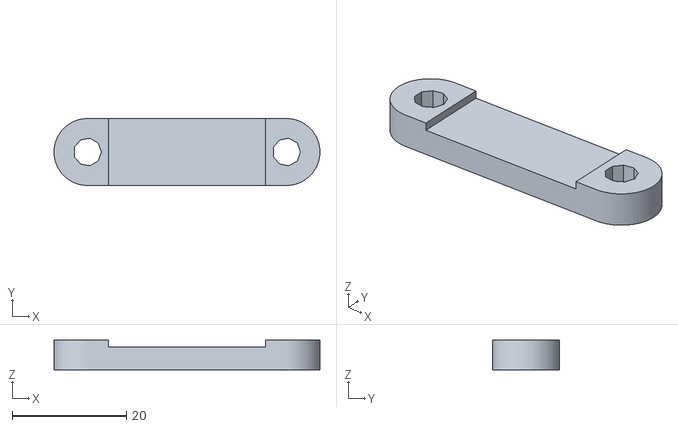
[picture p81: CAD file, 2015-10-09]
mendel/stls/ribbon_clamp_20_44.stl
46.5 x 11.7 x 5.20
