nnscr/Mendel90/nnscr/stls/printed/ribbon_clamps.stl

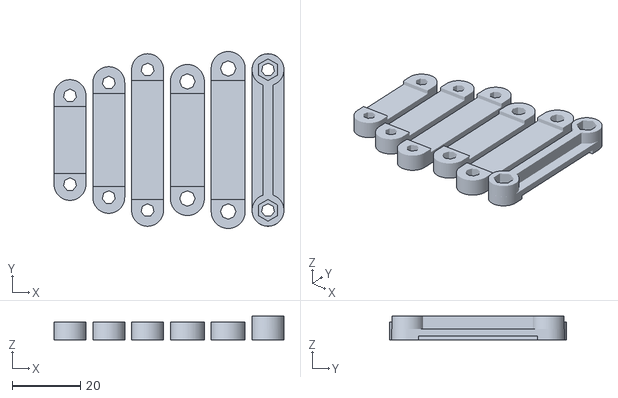
[picture p82: CAD file, 2015-10-19]
nnscr/stls/printed/ribbon_clamps.stl
67.6 x 52.0 x 7.01
