nnscr/Mendel90/dibond/stls/x_motor_bracket.stl

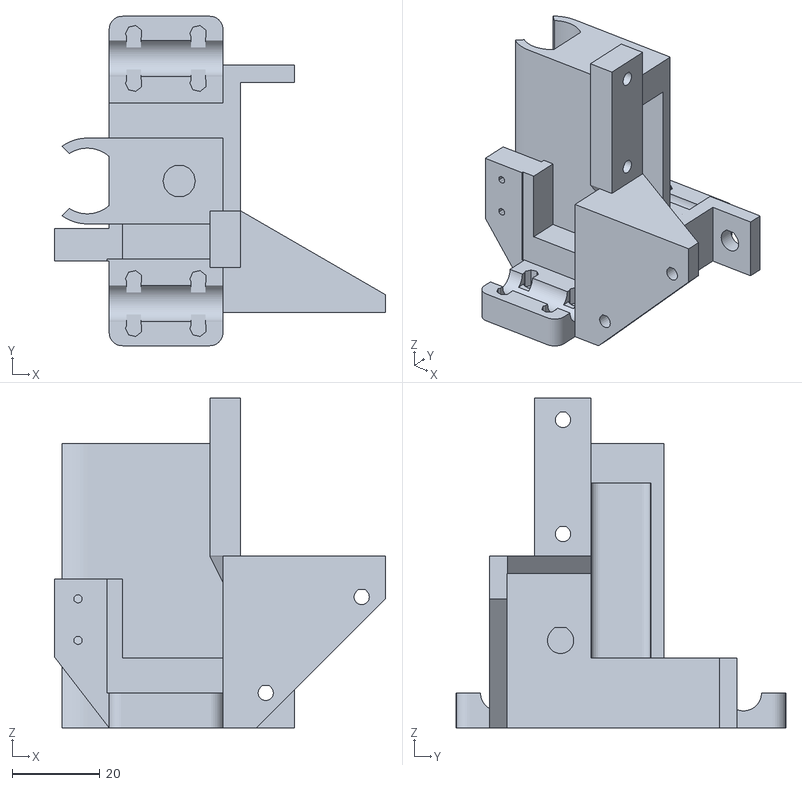
[picture p83: CAD file, 2015-10-09]
dibond/stls/x_motor_bracket.stl
75.6 x 75.3 x 75.4
