nnscr/Mendel90/mendel/stls/printed/y_bearing_mounts.stl

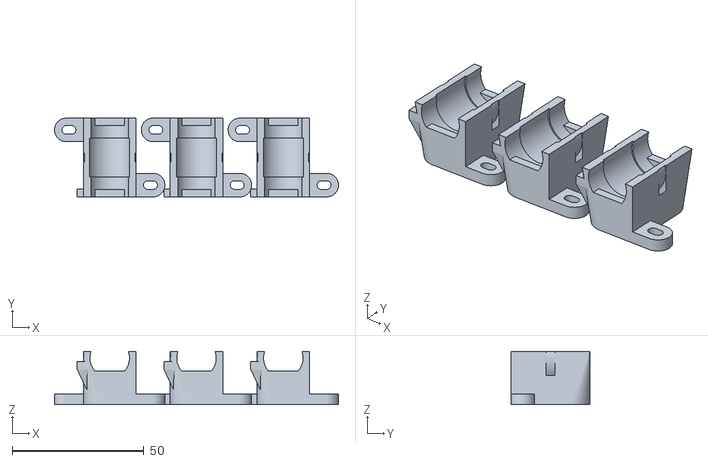
[picture p84: CAD file, 2015-10-09]
mendel/stls/printed/y_bearing_mounts.stl
108.0 x 30.0 x 20.2
