nnscr/Mendel90/nnscr/stls/printed/x_carriage_parts.stl

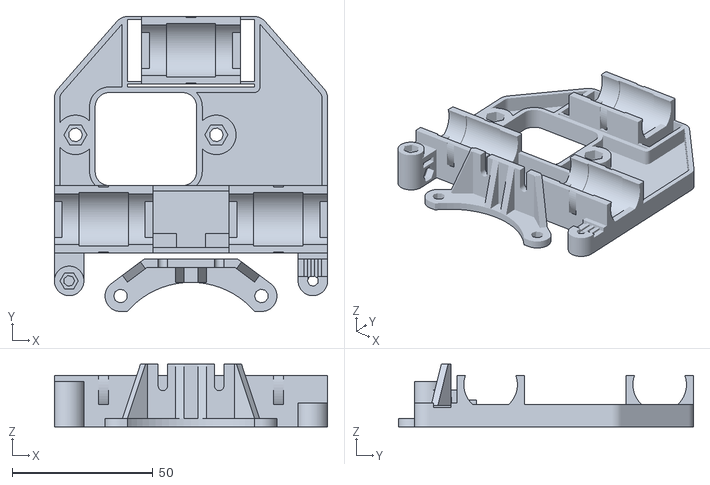
[picture p86: CAD file, 2015-10-19]
nnscr/stls/printed/x_carriage_parts.stl
97.0 x 104.7 x 22.3
