nnscr/Mendel90/dibond/stls/z_bar_clamp.stl

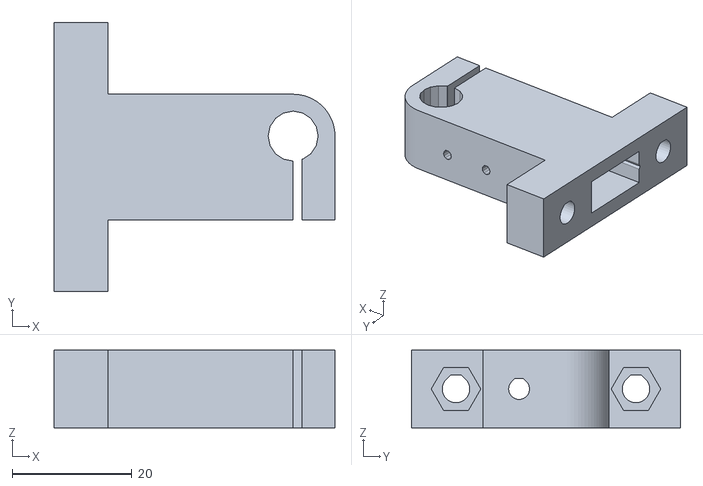
[picture p87: CAD file, 2015-10-09]
dibond/stls/z_bar_clamp.stl
47.0 x 45.0 x 13.0
