nnscr/Mendel90/mendel/stls/printed/atx_brackets.stl

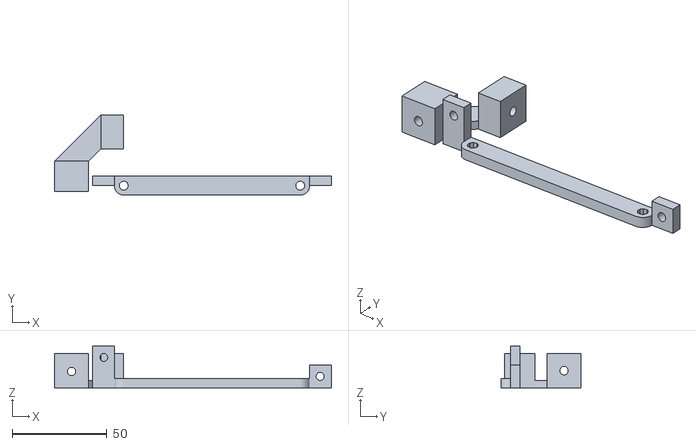
[picture p88: CAD file, 2015-10-09]
mendel/stls/printed/atx_brackets.stl
146.0 x 42.3 x 22.0
