nnscr/Mendel90/nnscr/stls/printed/d_motor_brackets.stl

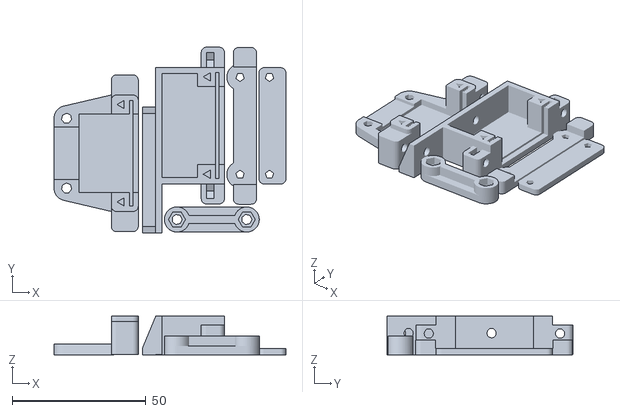
[picture p89: CAD file, 2015-10-19]
nnscr/stls/printed/d_motor_brackets.stl
86.7 x 69.4 x 14.4
