nnscr/Mendel90/dibond/stls/printed/y_idler_bracket.stl

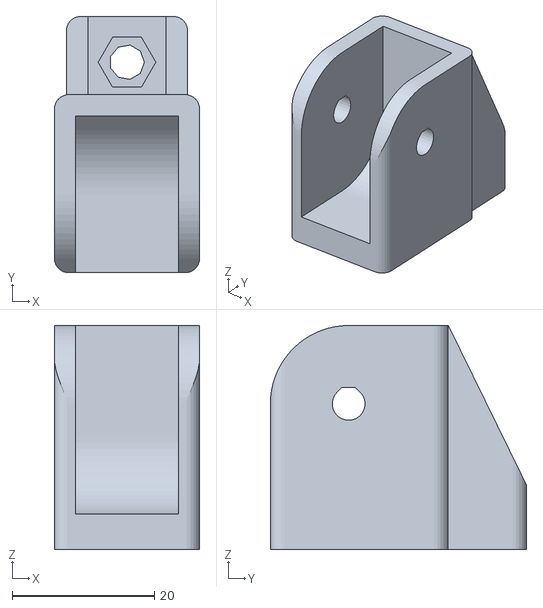
[picture p90: CAD file, 2015-10-09]
dibond/stls/printed/y_idler_bracket.stl
20.4 x 36.0 x 31.4
