nnscr/Mendel90/dibond/stls/y_bar_clamp_switch.stl

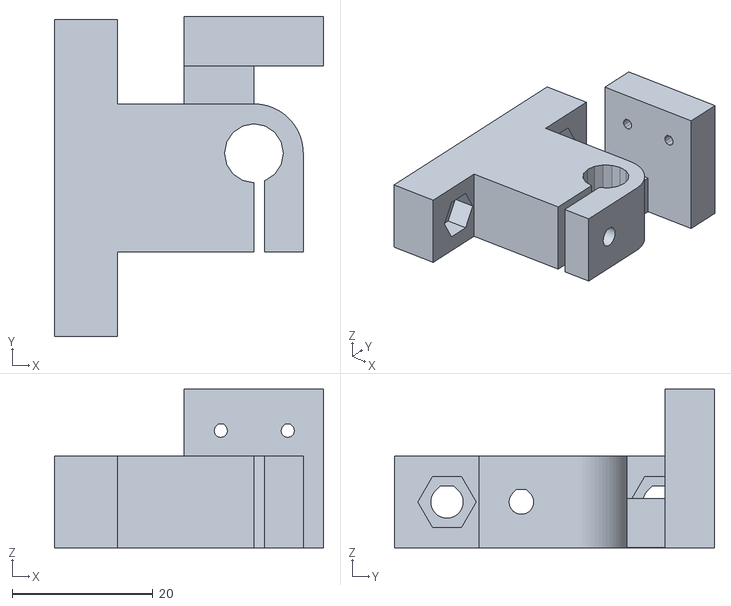
[picture p91: CAD file, 2015-10-09]
dibond/stls/y_bar_clamp_switch.stl
38.2 x 45.4 x 22.5
