nnscr/Mendel90/mendel/stls/printed/wades_extruder.stl

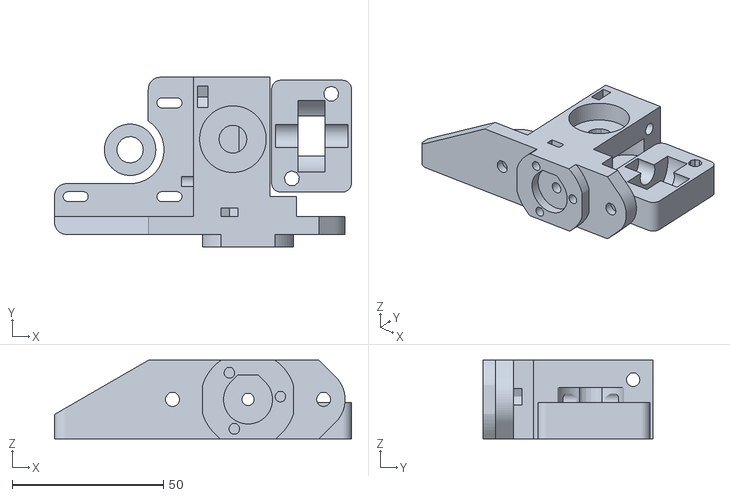
[picture p92: CAD file, 2015-10-09]
mendel/stls/printed/wades_extruder.stl
98.2 x 56.1 x 26.0
