nnscr/Mendel90/mendel/stls/x_carriage_fan_bracket.stl

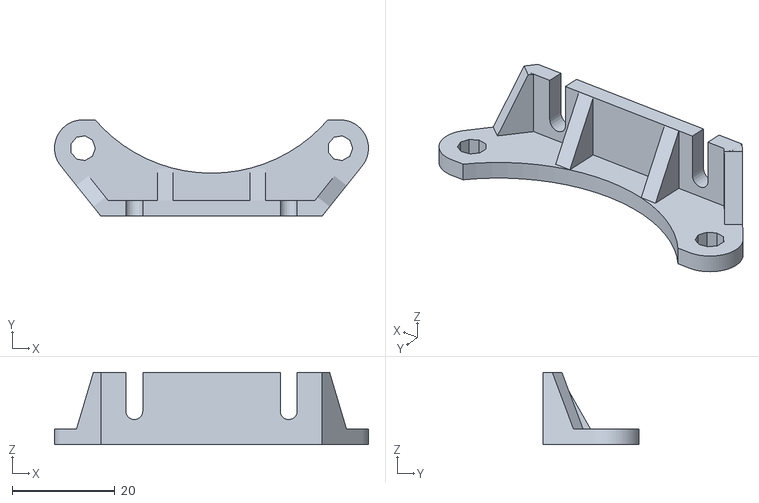
[picture p93: CAD file, 2015-10-09]
mendel/stls/x_carriage_fan_bracket.stl
61.0 x 18.7 x 14.0
