nnscr/Mendel90/nnscr/stls/ribbon_clamp_20_40.stl

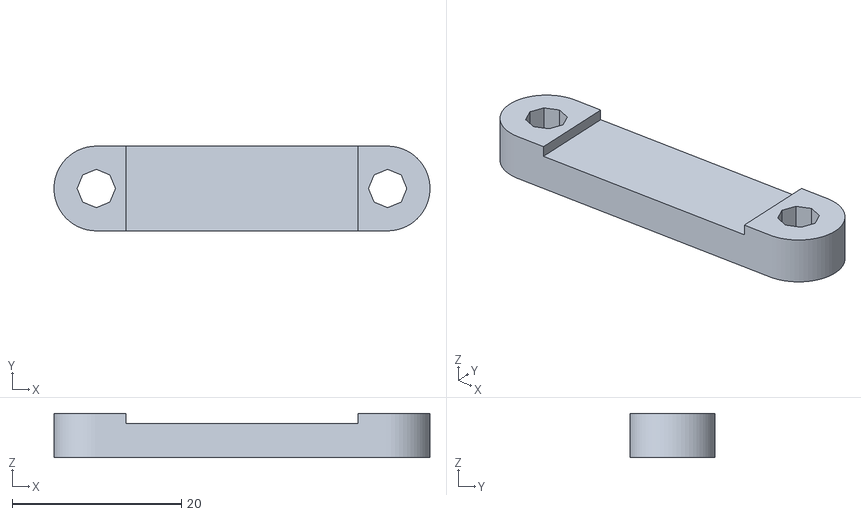
[picture p94: CAD file, 2015-10-19]
nnscr/stls/ribbon_clamp_20_40.stl
44.4 x 10.00 x 5.20
