nnscr/Mendel90/mendel/stls/printed/dust_filter.stl

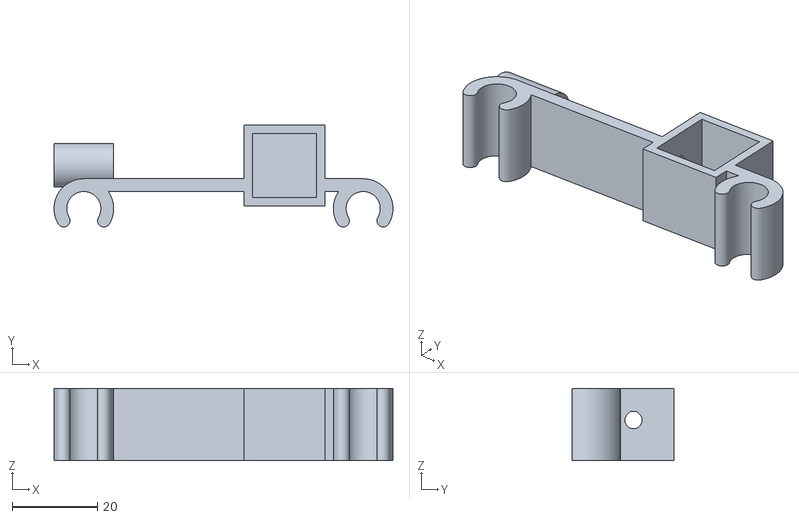
[picture p95: CAD file, 2015-10-09]
mendel/stls/printed/dust_filter.stl
79.5 x 23.9 x 17.0
