nnscr/Mendel90/mendel/stls/ribbon_clamp_26_33N.stl

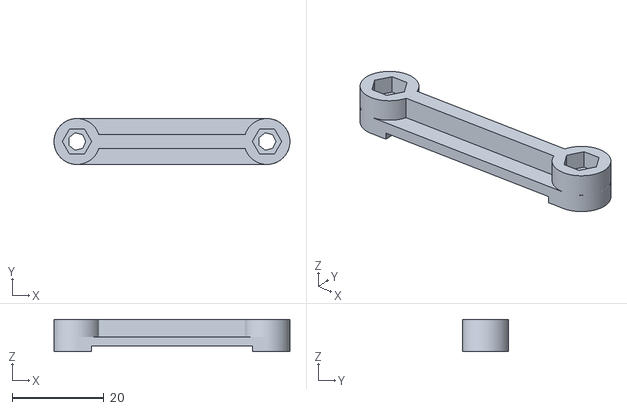
[picture p96: CAD file, 2015-10-09]
mendel/stls/ribbon_clamp_26_33N.stl
51.3 x 10.00 x 7.01
