nnscr/Mendel90/nnscr/stls/printed/y_bearing_mounts.stl

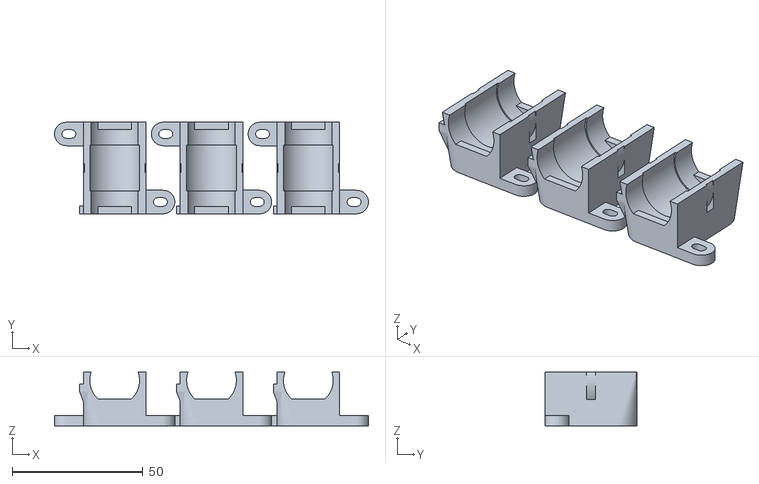
[picture p97: CAD file, 2015-10-19]
nnscr/stls/printed/y_bearing_mounts.stl
120.0 x 35.0 x 20.5
