nnscr/Mendel90/nnscr/stls/x_end_clamp.stl

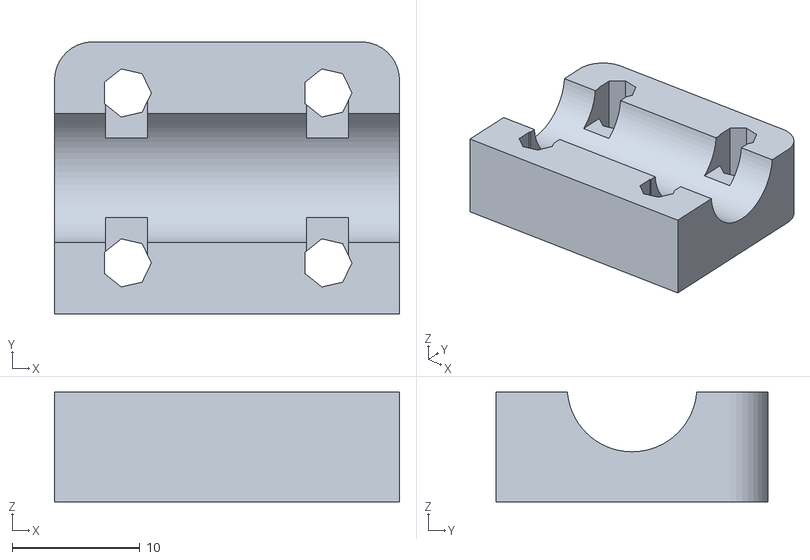
[picture p98: CAD file, 2015-10-19]
nnscr/stls/x_end_clamp.stl
27.0 x 21.3 x 8.60
