nnscr/Mendel90/dibond/stls/printed/cal.stl

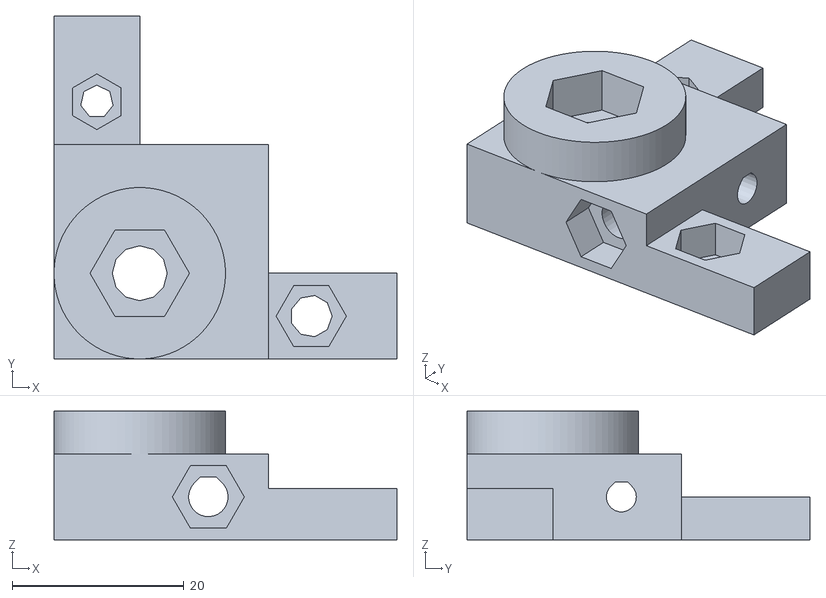
[picture p99: CAD file, 2015-10-09]
dibond/stls/printed/cal.stl
40.0 x 40.0 x 15.0
