nnscr/Mendel90/mendel/stls/printed/z_coupling.stl

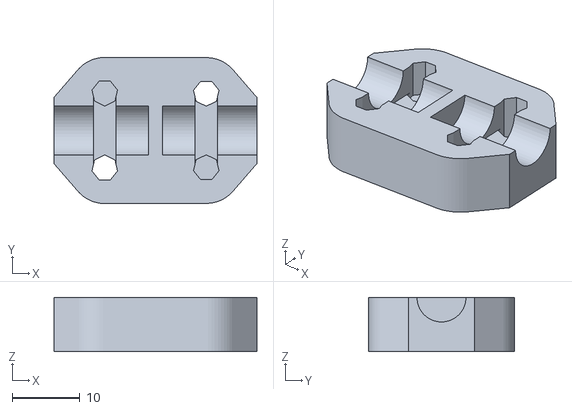
[picture p100: CAD file, 2015-10-09]
mendel/stls/printed/z_coupling.stl
30.0 x 21.6 x 8.00
