nnscr/Mendel90/nnscr/stls/printed/fixing_blocks.stl

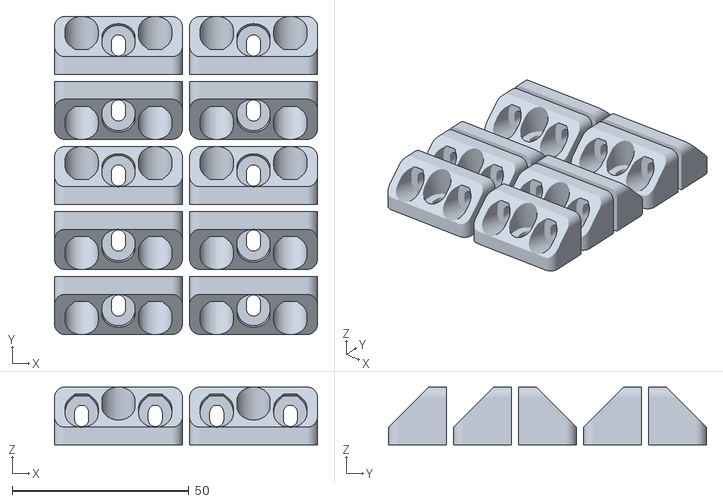
[picture p101: CAD file, 2015-10-19]
nnscr/stls/printed/fixing_blocks.stl
74.4 x 90.0 x 16.4
