nnscr/Mendel90/mendel/stls/ribbon_clamp_26_33.stl

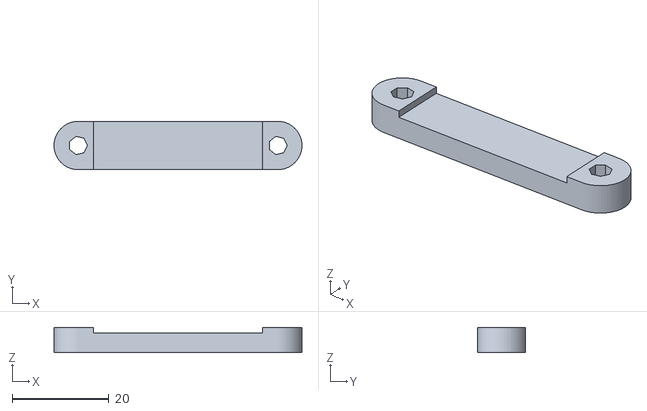
[picture p103: CAD file, 2015-10-09]
mendel/stls/ribbon_clamp_26_33.stl
51.3 x 10.00 x 5.20
