nnscr/Mendel90/nnscr/stls/y_bearing_mount.stl

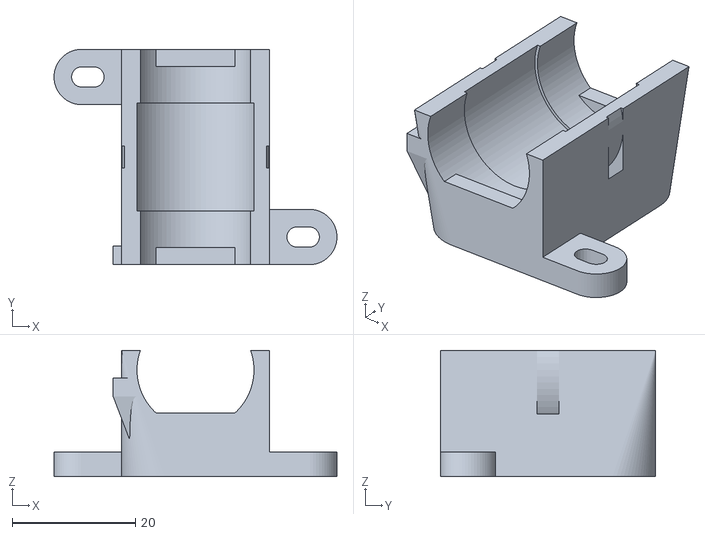
[picture p104: CAD file, 2015-10-19]
nnscr/stls/y_bearing_mount.stl
46.0 x 35.0 x 20.5
