nnscr/Mendel90/dibond/stls/y_bar_clamp.stl

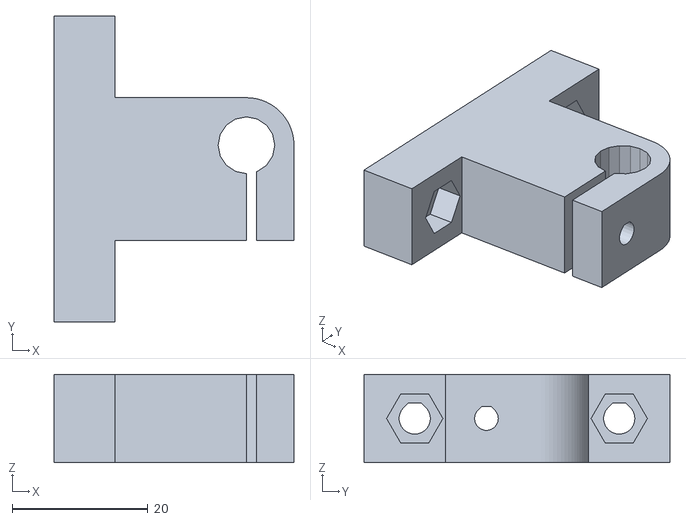
[picture p105: CAD file, 2015-10-09]
dibond/stls/y_bar_clamp.stl
35.3 x 45.0 x 13.0
