nnscr/Mendel90/mendel/stls/d_shell_lid.stl

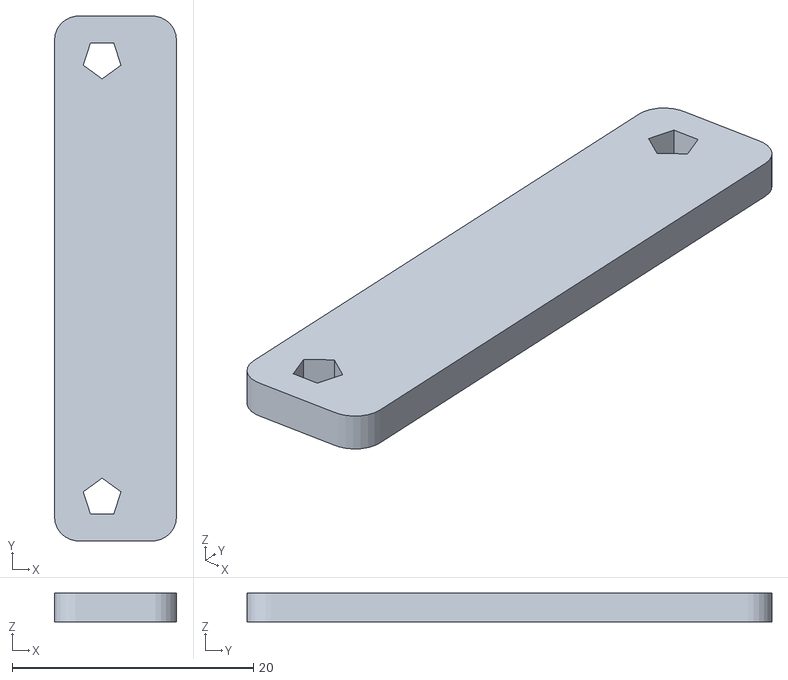
[picture p106: CAD file, 2015-10-09]
mendel/stls/d_shell_lid.stl
10.1 x 43.5 x 2.40
