nnscr/Mendel90/mendel/stls/printed/x_motor_ribbon_bracket.stl

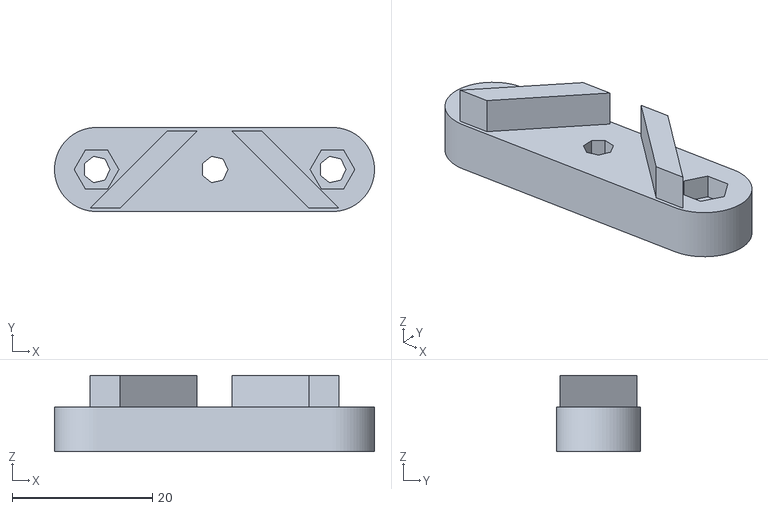
[picture p107: CAD file, 2015-10-09]
mendel/stls/printed/x_motor_ribbon_bracket.stl
45.7 x 12.0 x 10.9
