nnscr/Mendel90/nnscr/stls/fixing_block.stl

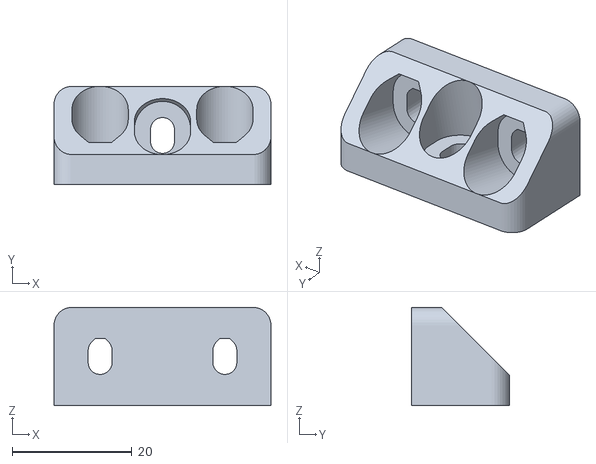
[picture p108: CAD file, 2015-10-19]
nnscr/stls/fixing_block.stl
36.2 x 16.4 x 16.4
