nnscr/Mendel90/nnscr/stls/printed/fan_guard.stl

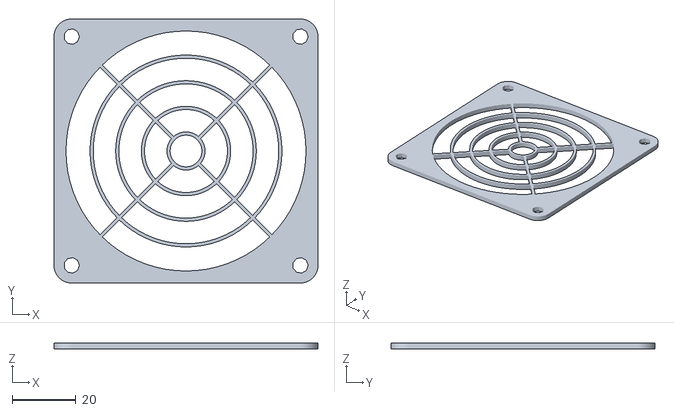
[picture p109: CAD file, 2015-10-19]
nnscr/stls/printed/fan_guard.stl
82.5 x 82.5 x 2.00
