nnscr/Mendel90/dibond/stls/x_belt_tensioner.stl

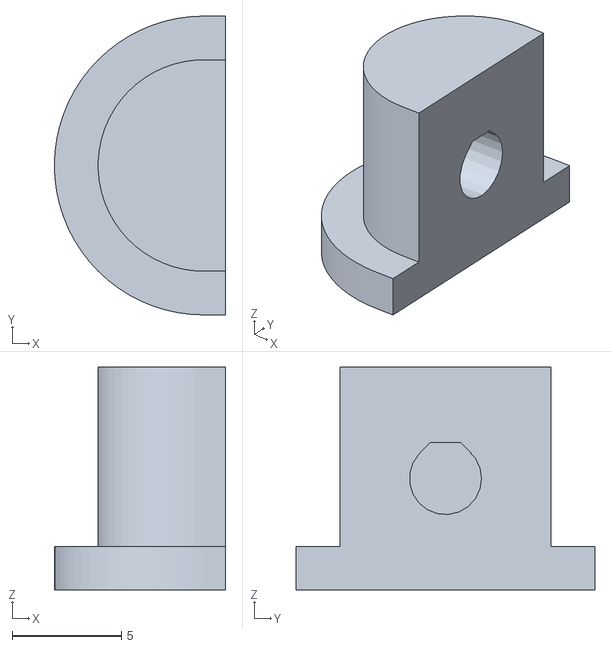
[picture p110: CAD file, 2015-10-09]
dibond/stls/x_belt_tensioner.stl
7.83 x 13.7 x 10.2
