nnscr/Mendel90/mendel/stls/atx_long_bracket.stl

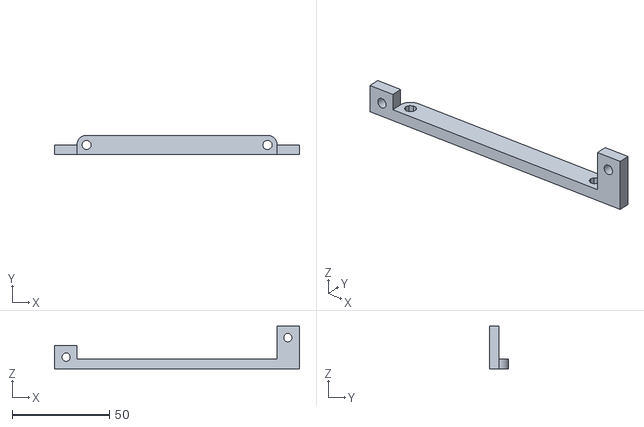
[picture p111: CAD file, 2015-10-09]
mendel/stls/atx_long_bracket.stl
126.0 x 10.00 x 22.0
