nnscr/Mendel90/nnscr/stls/ribbon_clamp_14_33NB.stl

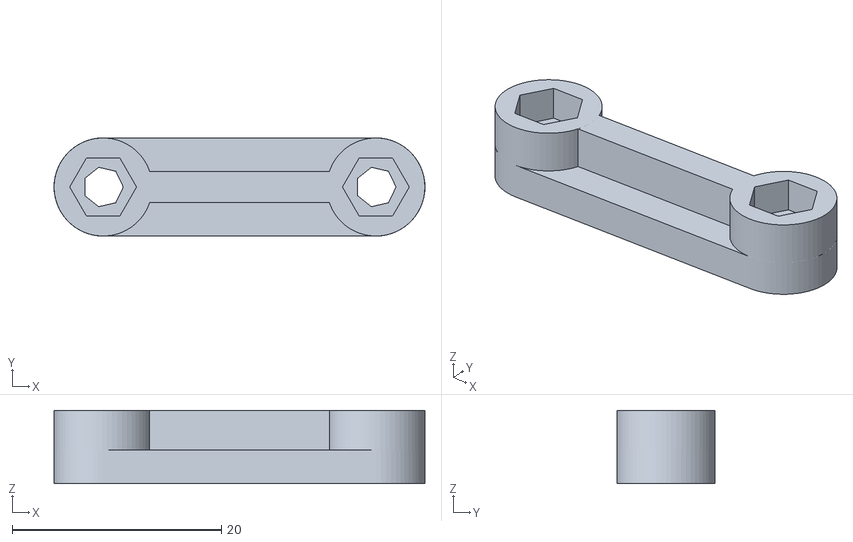
[picture p112: CAD file, 2015-10-19]
nnscr/stls/ribbon_clamp_14_33NB.stl
35.5 x 9.40 x 7.01
