nnscr/Mendel90/mendel/stls/z_bar_clamp.stl

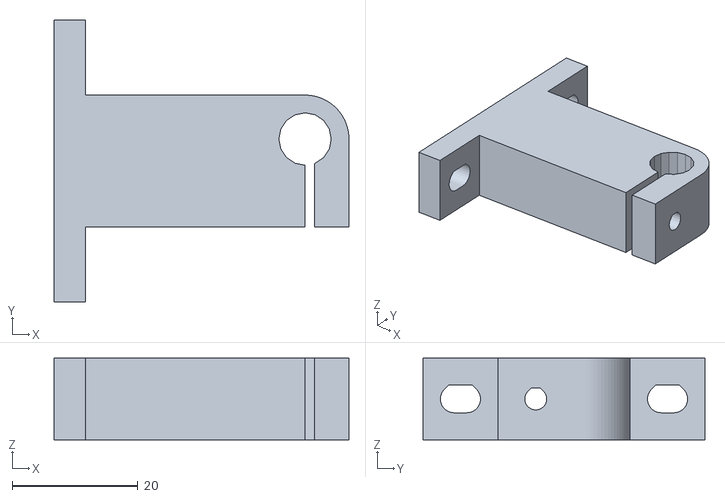
[picture p113: CAD file, 2015-10-09]
mendel/stls/z_bar_clamp.stl
47.0 x 45.0 x 13.0
