nnscr/Mendel90/nnscr/stls/z_bar_clamp.stl

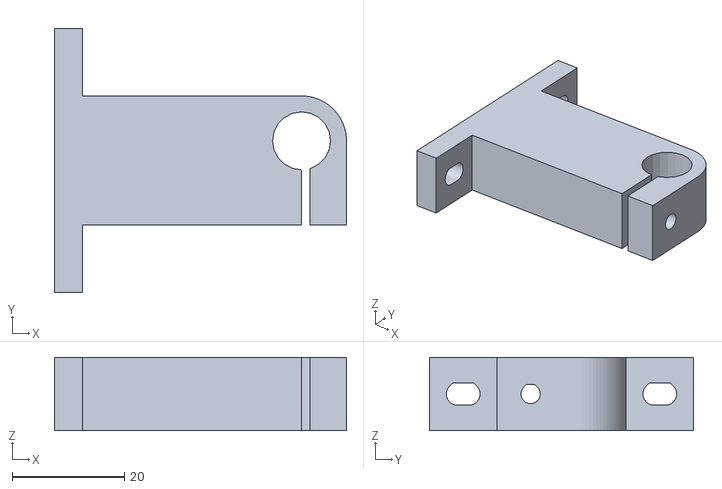
[picture p114: CAD file, 2015-10-19]
nnscr/stls/z_bar_clamp.stl
52.0 x 47.0 x 13.0
