nnscr/Mendel90/dibond/stls/x_carriage.stl

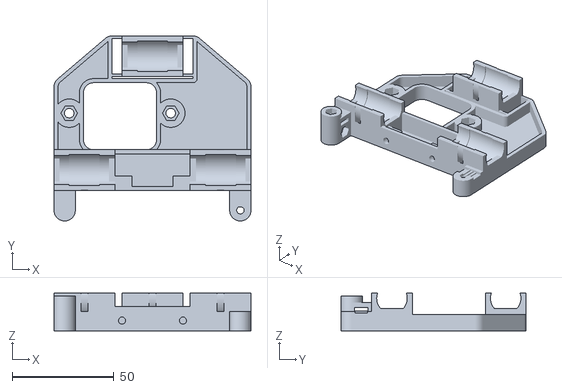
[picture p115: CAD file, 2015-10-09]
dibond/stls/x_carriage.stl
97.0 x 91.1 x 18.5
