nnscr/Mendel90/mendel/stls/cable_clip_AB.stl

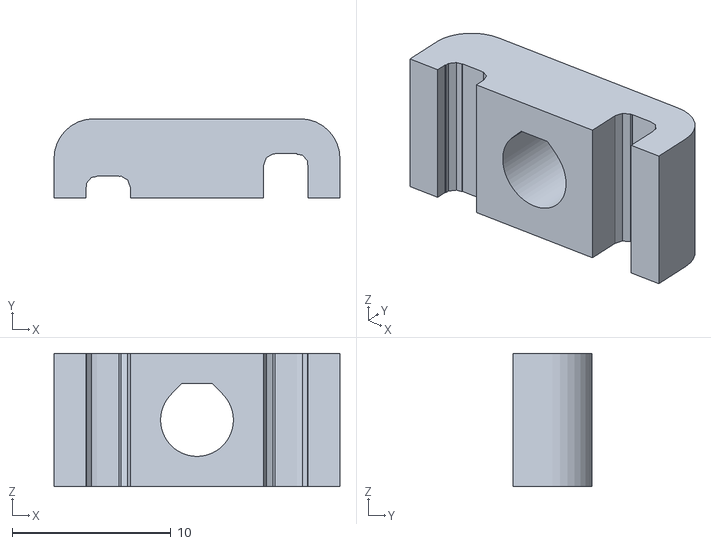
[picture p116: CAD file, 2015-10-09]
mendel/stls/cable_clip_AB.stl
18.0 x 5.00 x 8.40
