nnscr/Mendel90/nnscr/stls/cable_clip_AD.stl

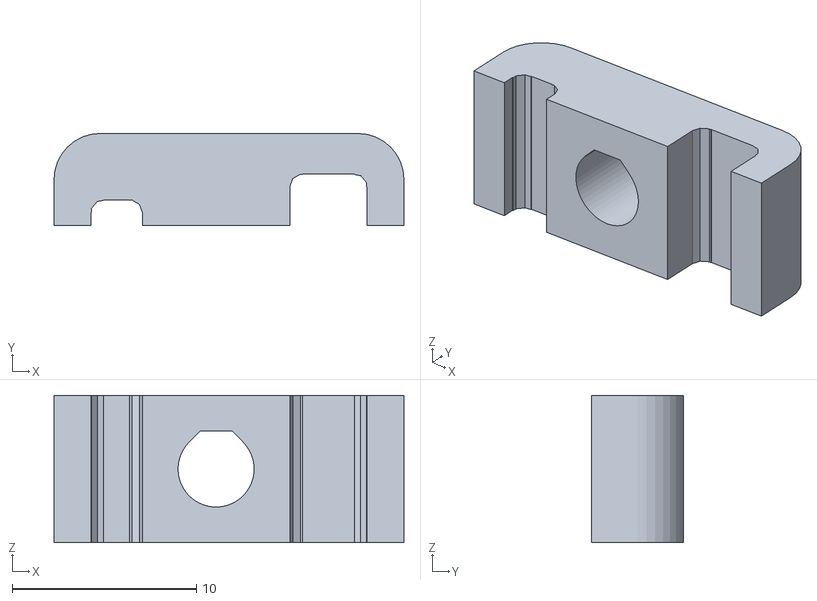
[picture p117: CAD file, 2015-10-19]
nnscr/stls/cable_clip_AD.stl
19.0 x 5.00 x 8.00
