nnscr/Mendel90/scad/conf/machine.scad

include <nnscr_config.scad>
