nnscr/Mendel90/(list of files, cad)

Other CAD files:
nnscr/frame_base.dxf
nnscr/frame_gantry_and_y_carriage.dxf
mendel/stls/printed/y_idler_bracket.stl
nnscr/stls/printed/wades_small_gear.stl
nnscr/stls/z_motor_bracket_rhs.stl
nnscr/stls/y_belt_anchor.stl
nnscr/stls/printed/y_motor_bracket.stl
dibond/stls/z_motor_bracket_lhs.stl
nnscr/stls/y_belt_anchor_toothed.stl
mendel/stls/printed/small_bits.stl
nnscr/stls/printed/y_belt_anchors.stl
mendel/stls/printed/d_motor_brackets.stl
dibond/stls/atx_long_bracket.stl
dibond/stls/z_screw_pointer.stl
mendel/stls/cable_clip_AD.stl
mendel/stls/cable_clip_CA.stl
mendel/stls/d_motor_bracket.stl
mendel/stls/pcb_spacer.stl
mendel/stls/printed/bar_clamps.stl
mendel/stls/ribbon_clamp_20_33.stl
mendel/stls/spool_bracket_female.stl
mendel/stls/spool_bracket_male.stl
mendel/stls/wades_gear_spacer.stl
mendel/stls/x_belt_clamp.stl
mendel/stls/y_bar_clamp.stl
mendel/stls/y_bar_clamp_switch.stl
mendel/stls/y_bearing_mount.stl
mendel/stls/y_belt_clip.stl
mendel/stls/y_idler_bracket.stl
mendel/stls/z_motor_bracket_lhs.stl
mendel/stls/z_motor_bracket_rhs.stl
mendel/stls/z_screw_pointer.stl
nnscr/frame_stays.dxf
nnscr/sheets/frame_base_dxf.scad
nnscr/sheets/frame_gantry_and_y_carriage_dxf.scad
nnscr/sheets/frame_gantry_dxf.scad
nnscr/sheets/frame_left_dxf.scad
nnscr/sheets/frame_right_dxf.scad
nnscr/sheets/frame_stays_dxf.scad
nnscr/sheets/y_carriage_dxf.scad
nnscr/sheets/y_heatshield_dxf.scad
nnscr/stls/cable_clip_AB.stl
nnscr/stls/cable_clip_CA.stl
nnscr/stls/d_shell.stl
nnscr/stls/ribbon_clamp_20_33.stl
nnscr/stls/ribbon_clamp_26_33.stl
nnscr/stls/ribbon_clamp_26_33N.stl
nnscr/stls/ribbon_clamp_26_40.stl
nnscr/stls/wades_gear_spacer.stl
nnscr/stls/wades_idler_block.stl
nnscr/stls/wades_small_gear.stl
nnscr/stls/x_belt_clamp.stl
nnscr/stls/x_belt_grip.stl
nnscr/stls/x_belt_tensioner.stl
nnscr/stls/x_carriage.stl
nnscr/stls/y_bar_clamp.stl
nnscr/stls/y_belt_clip.stl
nnscr/stls/y_belt_clip_toothed.stl
nnscr/stls/y_motor_bracket.stl
nnscr/stls/z_screw_pointer.stl
