nnscr/Mendel90/nnscr/bom/hot_end_assembly.txt

hot_end_assembly:
Vitamins:
  1 Fan 30mm x 10mm

Printed:
