nnscr/Mendel90/nnscr/bom/x_axis_assembly.txt

x_axis_assembly:
Vitamins:
  1 Belt T2.5 x 6mm x 875mm
  2 Nut M4
  2 Smooth rod 10mm x 389mm

Printed:

Sub-assemblies:
  1 extruder_assembly
  1 x_carriage_assembly
