nnscr/Mendel90/nnscr/bom/y_axis_assembly.txt

y_axis_assembly:
Vitamins:
  1 Belt T2.5 x 6mm x 655mm
  4 M3 cap screw x 20mm
  4 Nyloc nut M3
  2 No2 pan wood screw x 13mm
  8 No6 pan wood screw x 20mm
  1 Smooth rod 10mm x 276mm
  1 Smooth rod 10mm x 418mm
  1 Microswitch
  2 Washer M2.5 x 5.9mm x 0.5mm
  4 Washer M3 x 7mm x 0.5mm
  8 Washer M4 x 9mm x 0.8mm
  8 Star washer M4 x 0.8mm

Printed:
  3 y_bar_clamp.stl
  1 y_bar_clamp_switch.stl

Sub-assemblies:
  1 print_bed_assembly
  1 y_idler_assembly
  1 y_motor_assembly
