nnscr/Mendel90/nnscr/bom/y_motor_assembly.txt

y_motor_assembly:
Vitamins:
  1 M4 grub screw x 6mm
  1 NEMA17 x 47mm stepper motor
  4 M3 pan screw x 8mm
  4 No6 pan wood screw x 20mm
  1 T2.5 pulley 16 teeth
  4 Washer M3 x 7mm x 0.5mm
  4 Washer M4 x 9mm x 0.8mm
  4 Star washer M3 x 0.5mm
  4 Star washer M4 x 0.8mm

Printed:
  1 y_motor_bracket.stl
