nnscr/Mendel90/nnscr/bom/electronics_assembly.txt

electronics_assembly:
Vitamins:
  1 Arduino Mega 2560
  2 Heatshrink sleeving ID 2.4mm x 15mm

Printed:
