nnscr/Mendel90/nnscr/bom/x_carriage_assembly.txt

x_carriage_assembly:
Vitamins:
  1 M3 cap screw x 20mm
  2 M3 cap screw x 25mm
  3 LM10UU linear bearing
  1 Nut M3
  2 Nyloc nut M3
  2 Washer M3 x 7mm x 0.5mm
  3 Ziptie 105mm min length

Printed:
  1 x_belt_clamp.stl
  1 x_belt_grip.stl
  1 x_belt_tensioner.stl
  1 x_carriage.stl
