nnscr/Mendel90/nnscr/sheets/frame_base.pdf

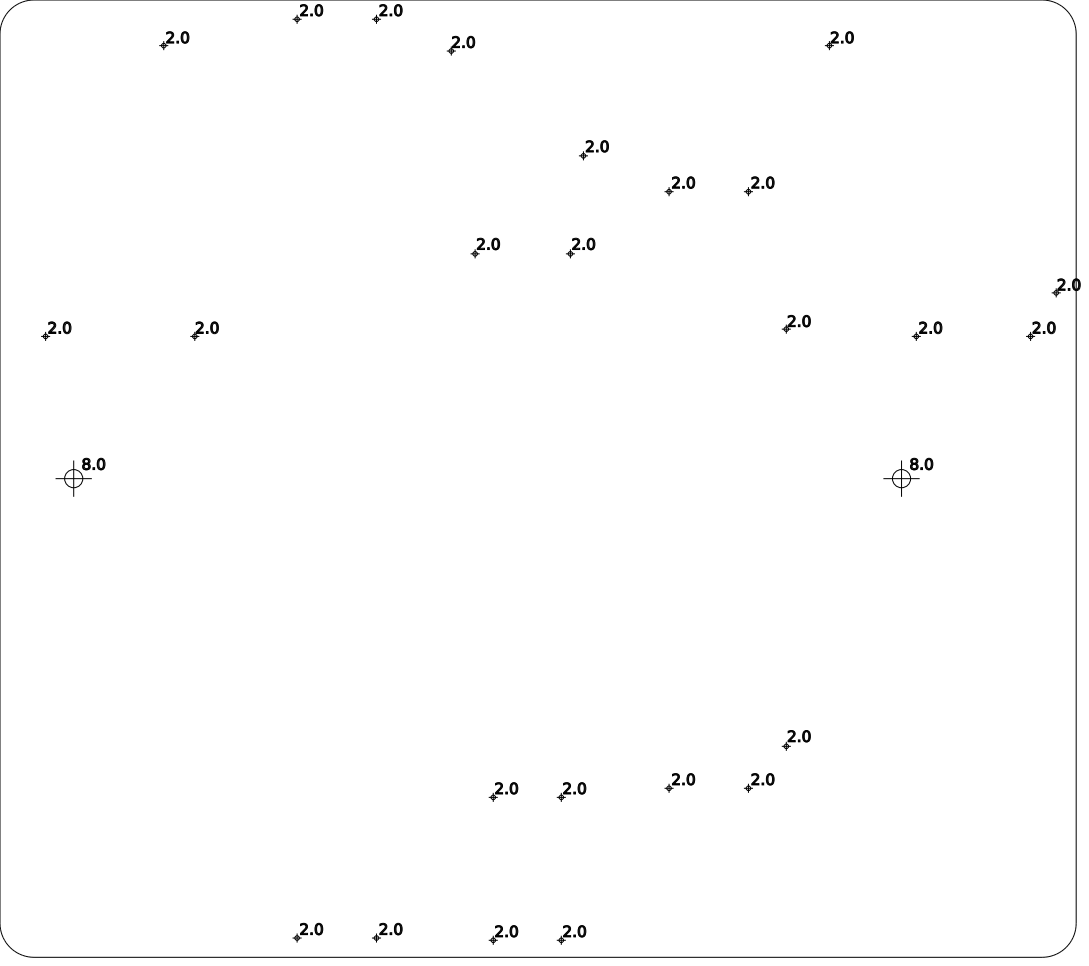
[picture p118: page 1]
