nnscr/Mendel90/nnscr/sheets/frame_gantry.pdf

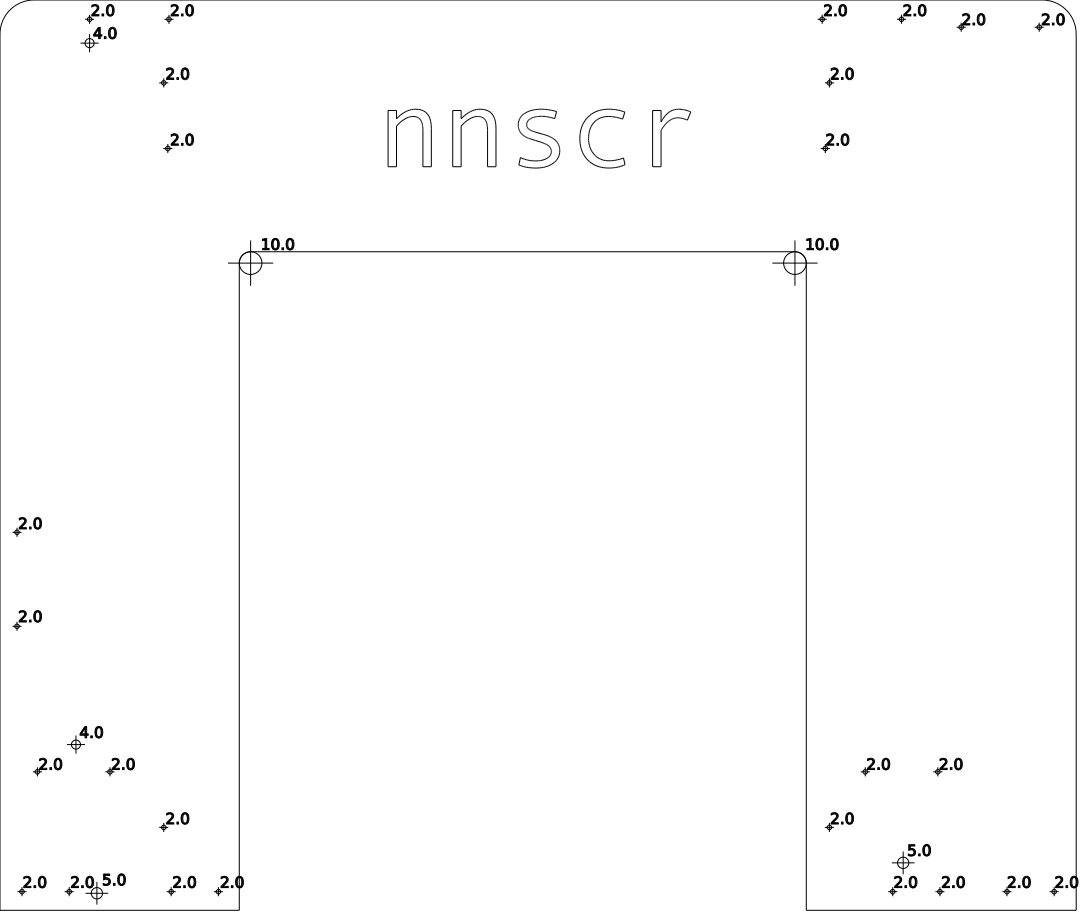
[picture p119: page 1]
