nnscr/Mendel90/nnscr/sheets/frame_gantry_and_y_carriage.pdf

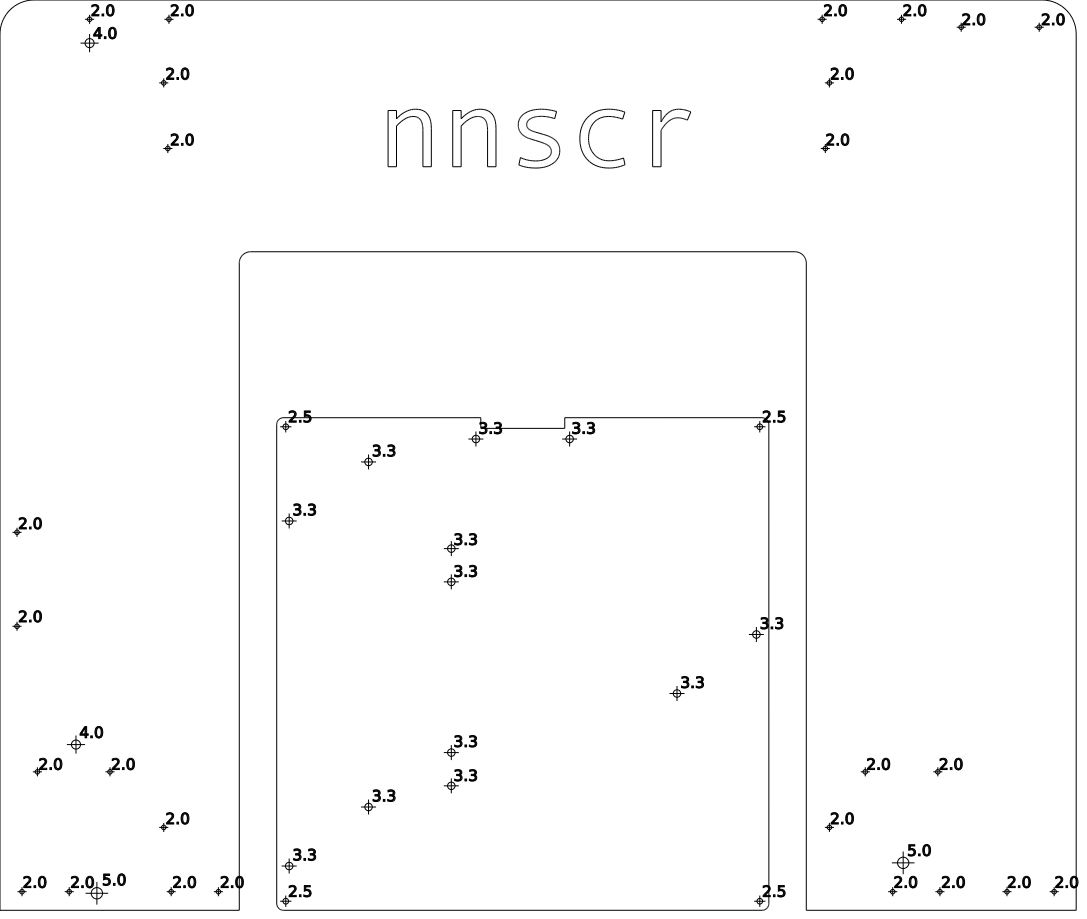
[picture p120: page 1]
