nnscr/Mendel90/nnscr/sheets/frame_left.pdf

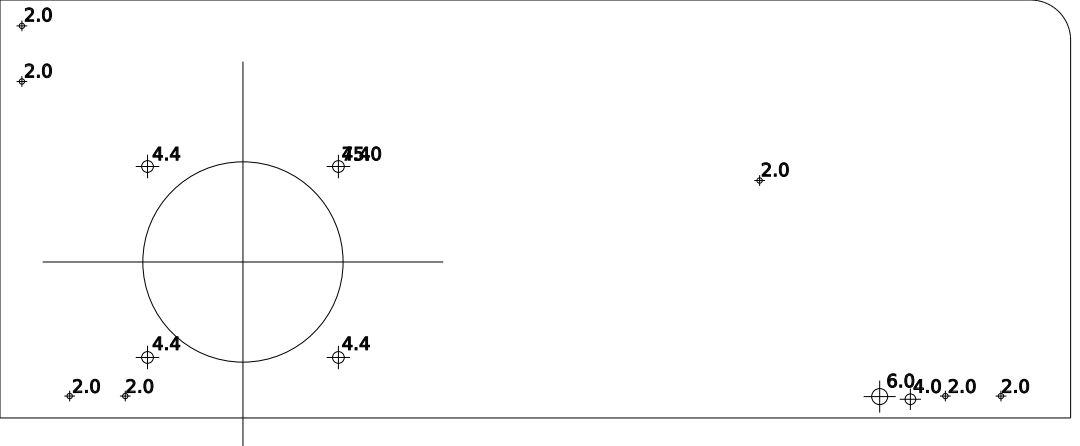
[picture p121: page 1]
