nnscr/Mendel90/nnscr/sheets/frame_right.pdf

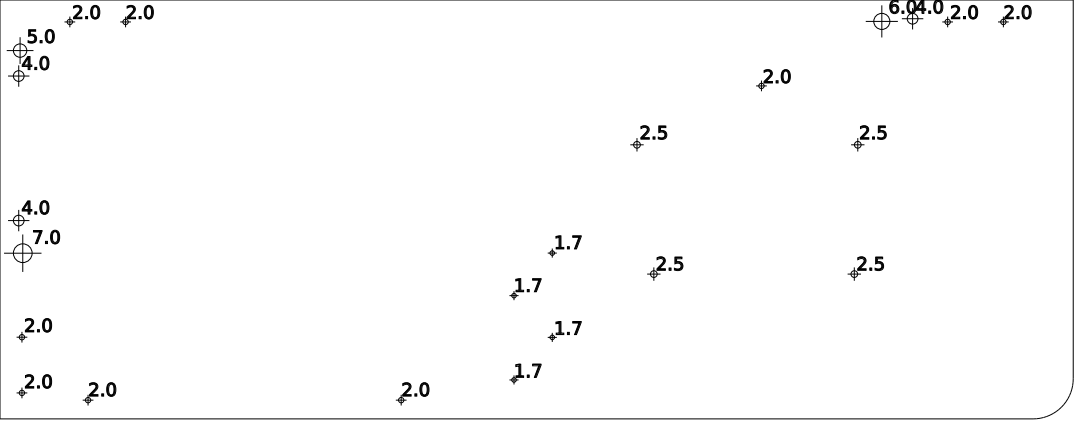
[picture p122: page 1]
