nnscr/Mendel90/nnscr/sheets/frame_stays.pdf

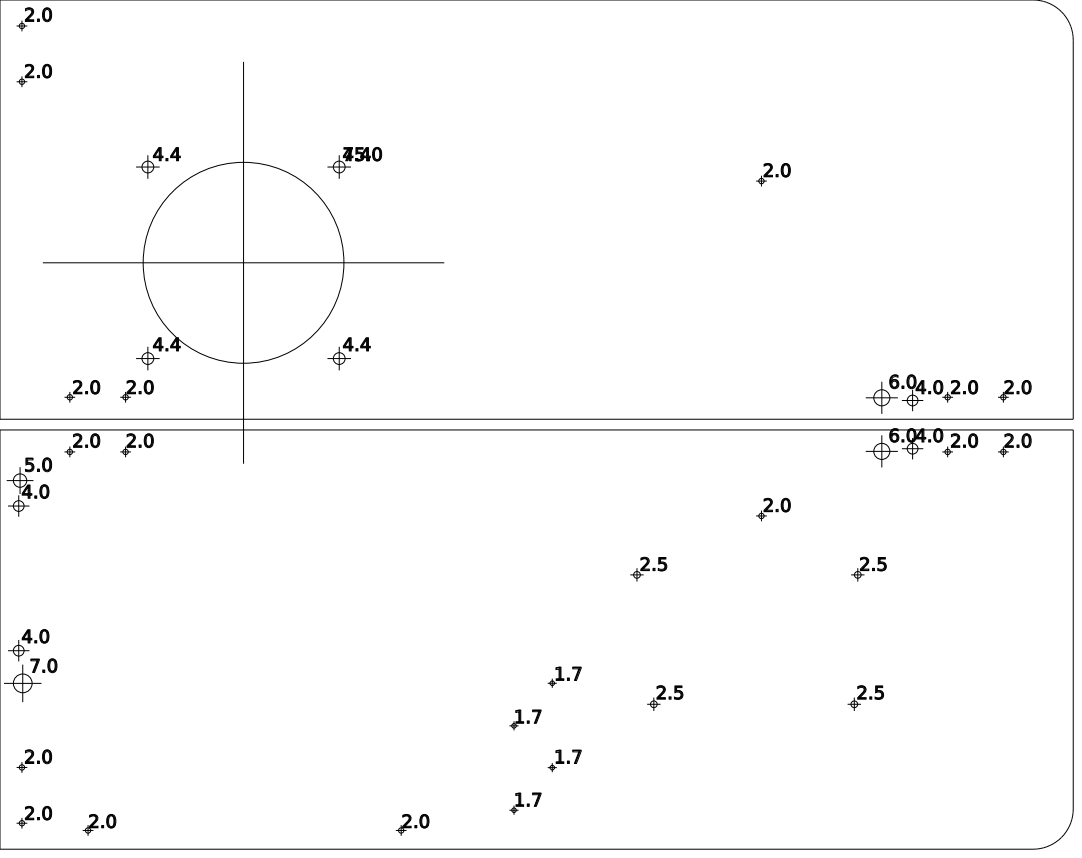
[picture p123: page 1]
