nnscr/Mendel90/nnscr/sheets/y_carriage.pdf

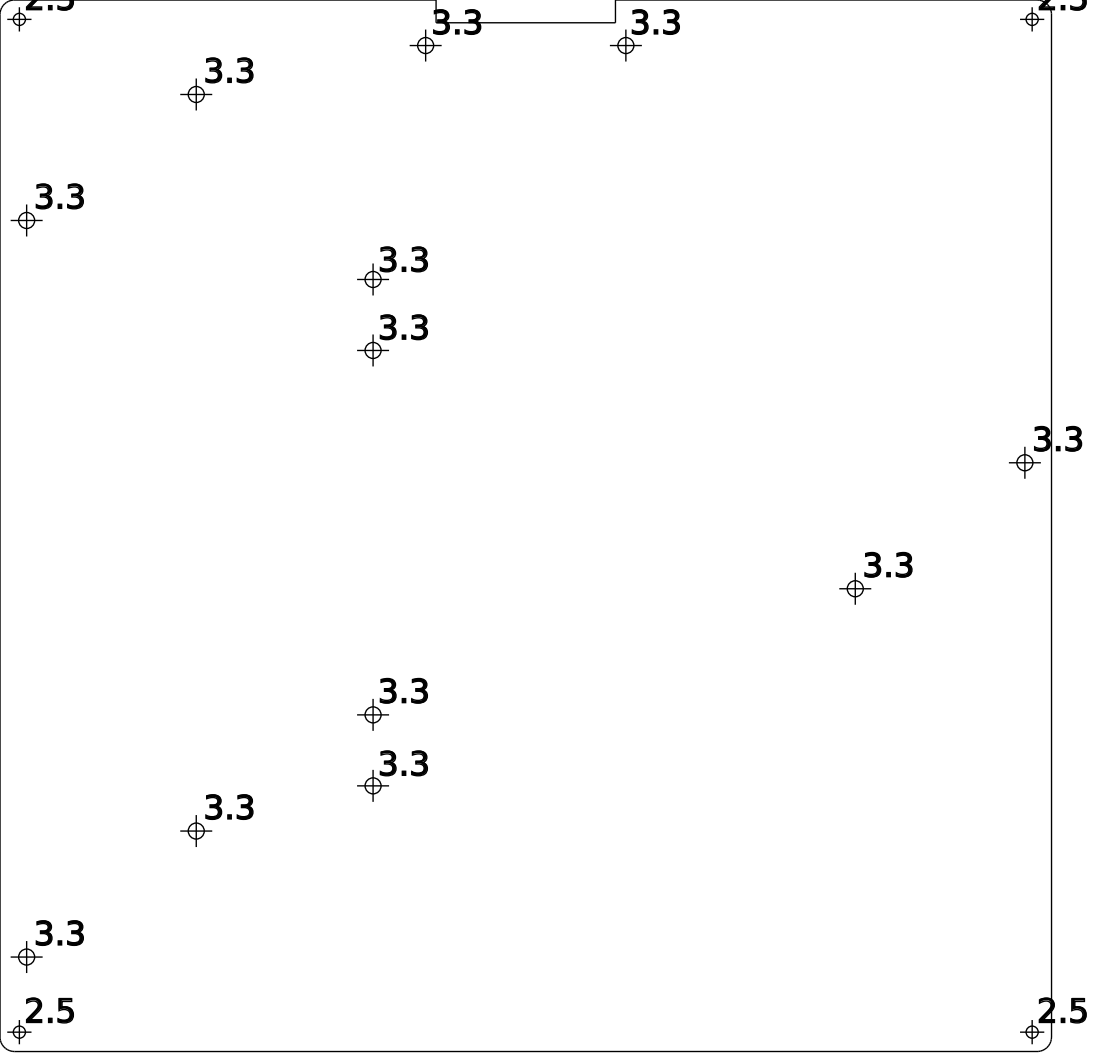
[picture p124: page 1]
