nnscr/Mendel90/dibond/sheets/frame_base.pdf

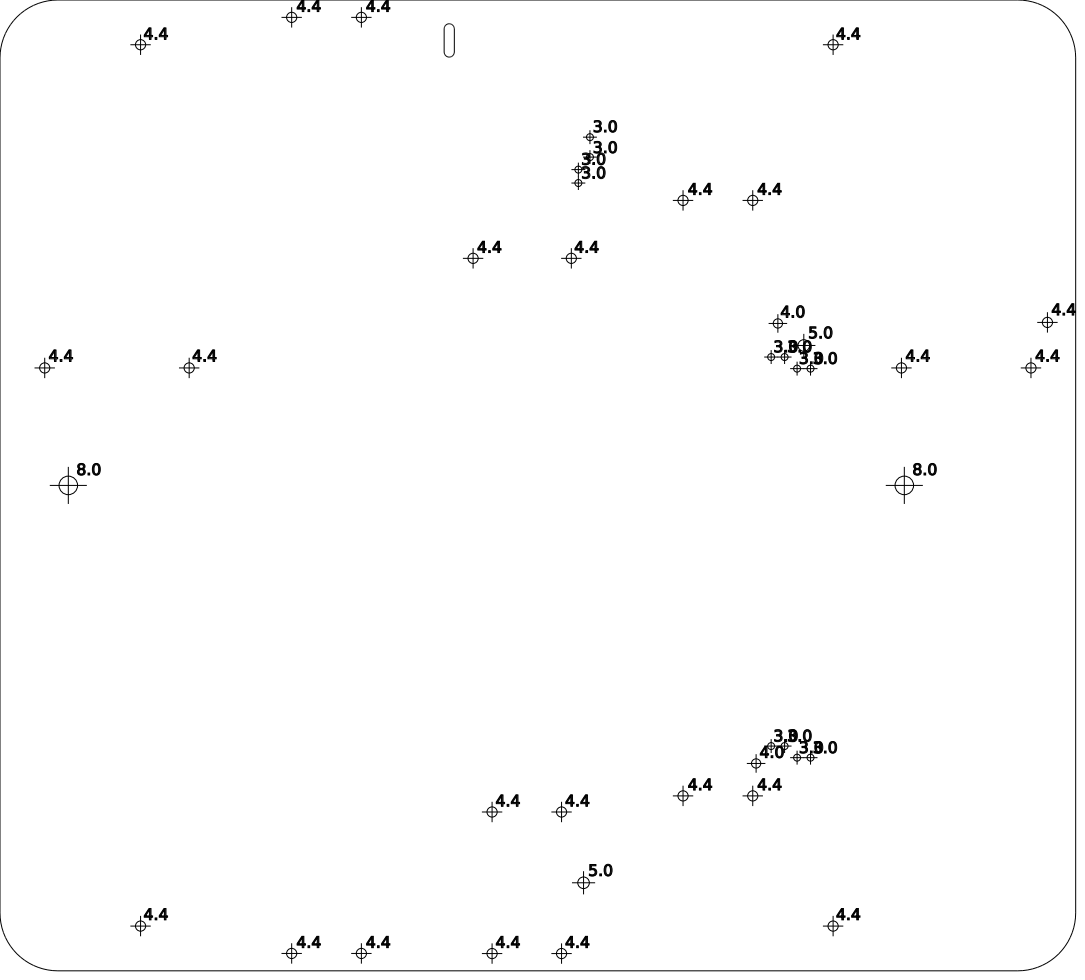
[picture p125: page 1]
