nnscr/Mendel90/dibond/sheets/frame_gantry.pdf

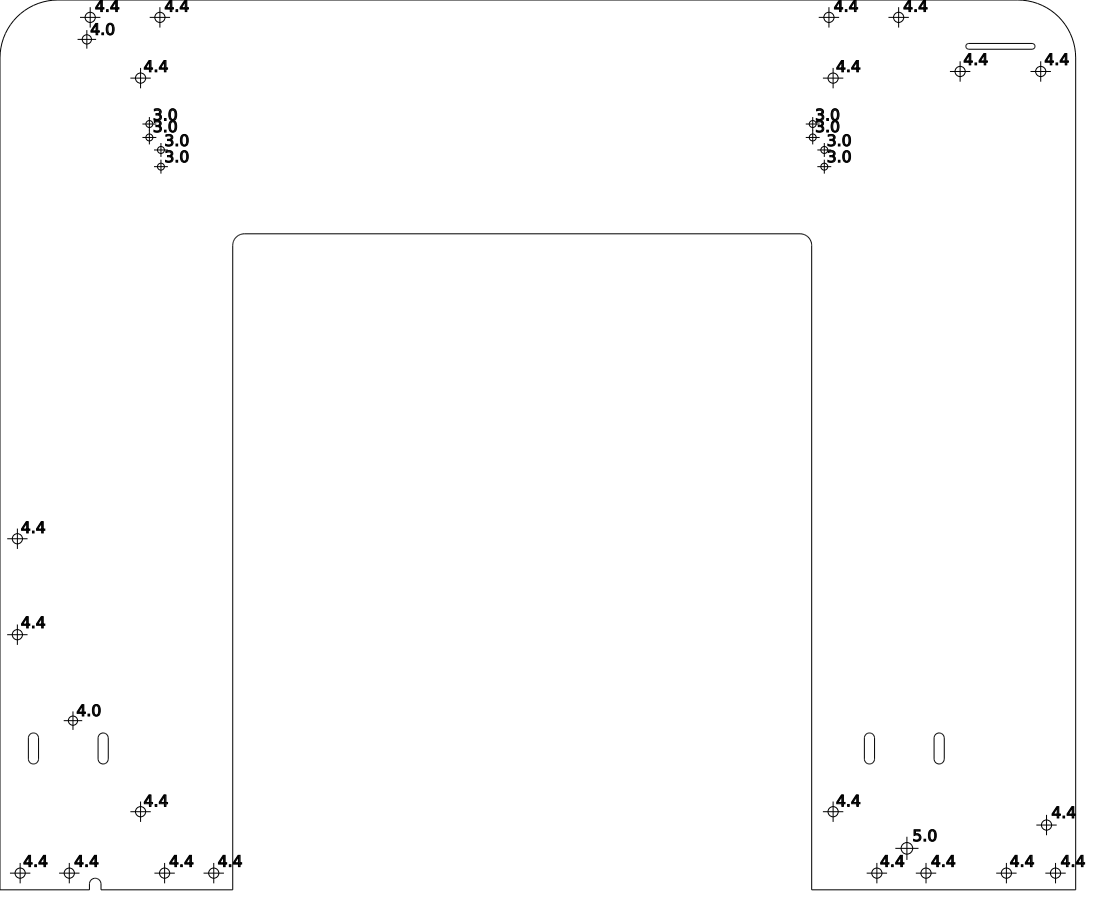
[picture p126: page 1]
