nnscr/Mendel90/dibond/sheets/frame_gantry_and_y_carriage.pdf

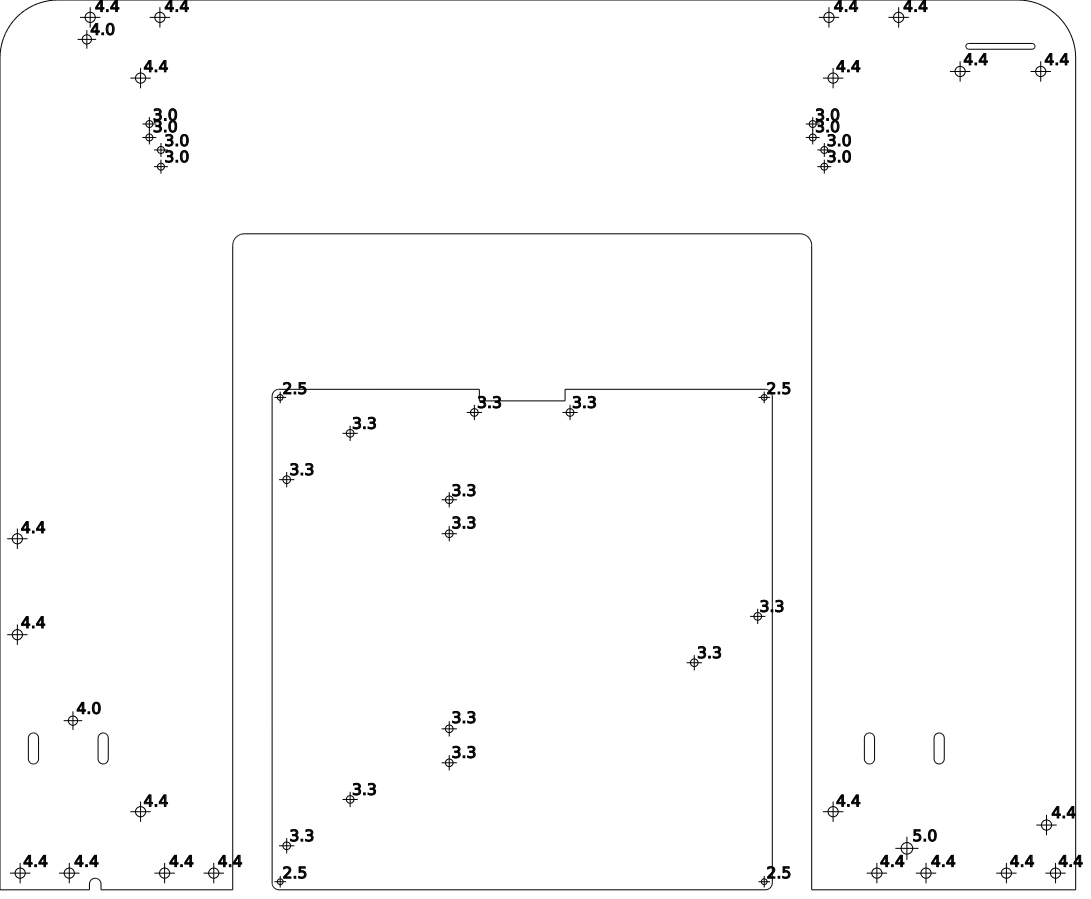
[picture p127: page 1]
