nnscr/Mendel90/dibond/sheets/frame_left.pdf

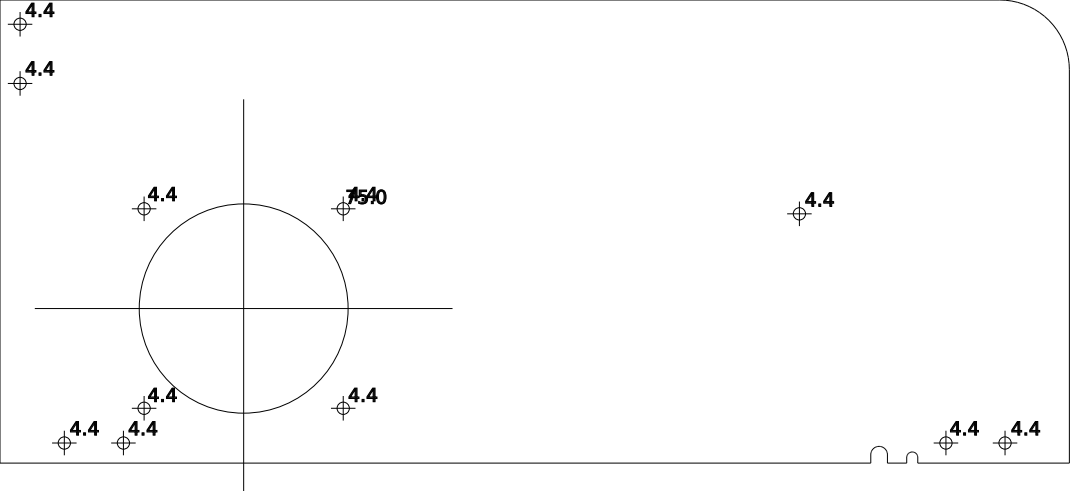
[picture p128: page 1]
