nnscr/Mendel90/dibond/sheets/frame_right.pdf

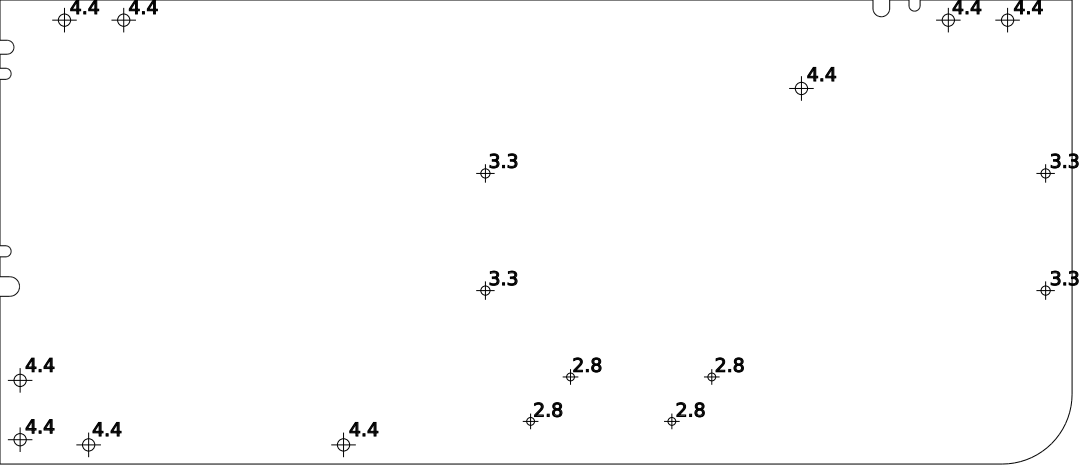
[picture p129: page 1]
