nnscr/Mendel90/dibond/sheets/frame_stays.pdf

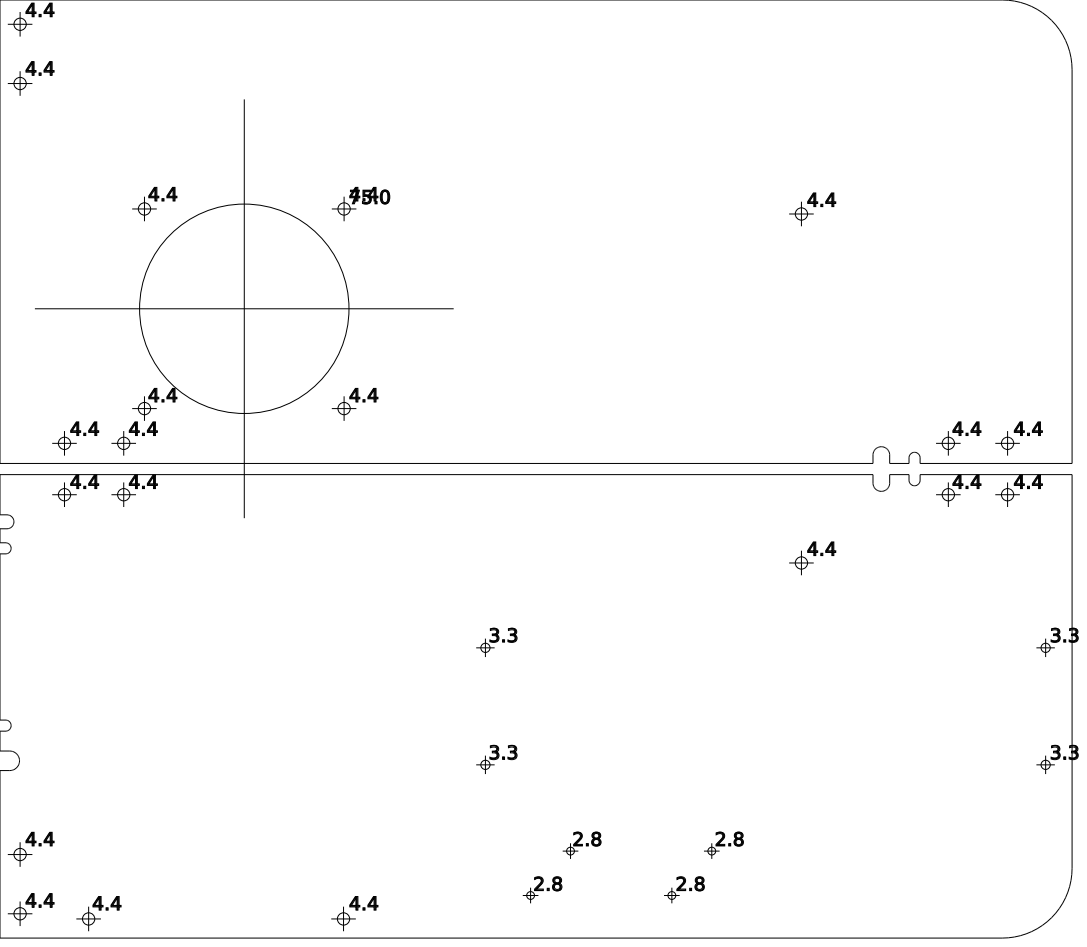
[picture p130: page 1]
