nnscr/Mendel90/dibond/sheets/y_carriage.pdf

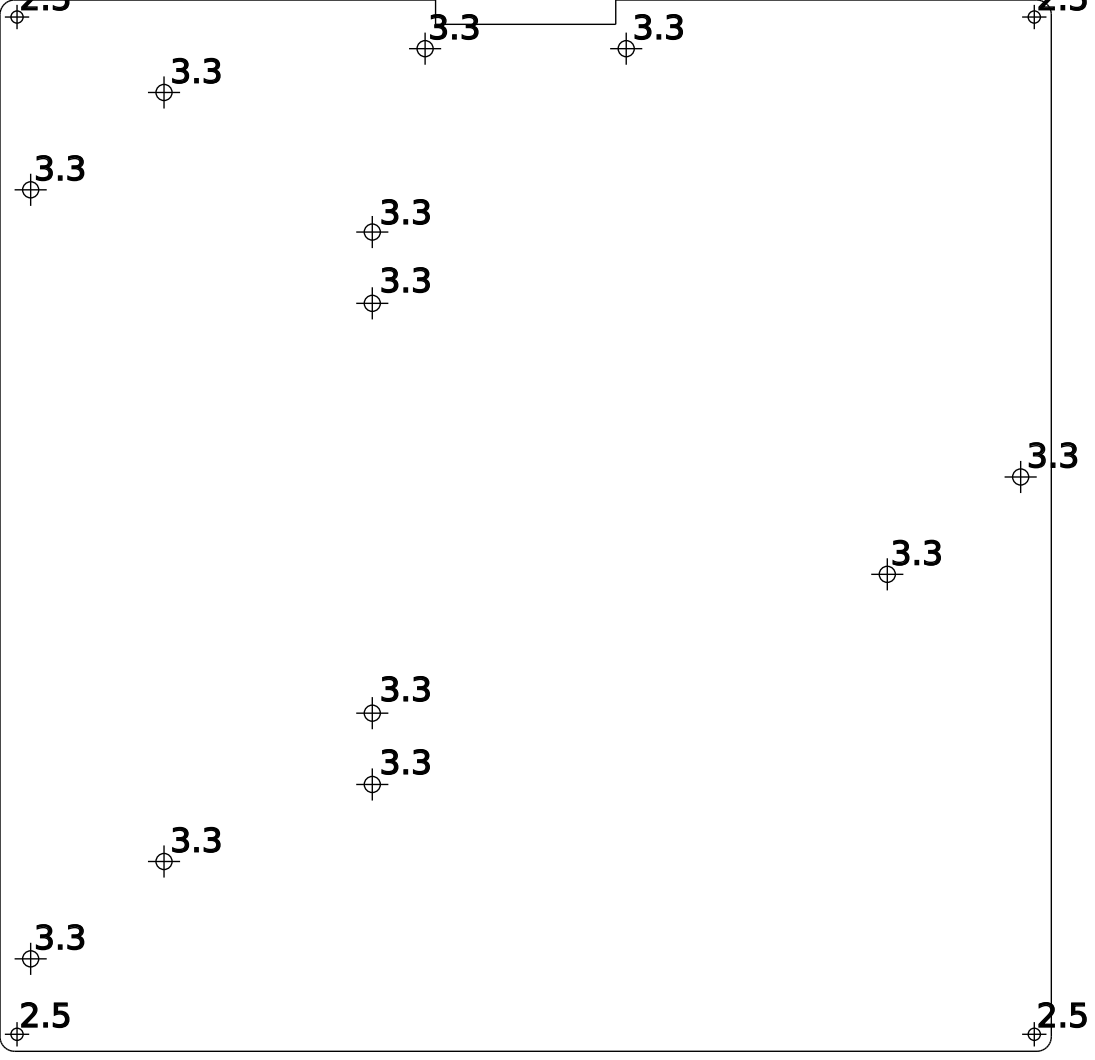
[picture p131: page 1]
