nnscr/Mendel90/(commit log)

2015-10-09 added e3d v6 hotend and customizable logo
    [e3d_v6_all_metal_hotend.scad, hot_ends.scad, main.scad, nnscr_config.scad, wade.scad, x-carriage.scad]
2015-10-11 mounting the e3d hotend
    [E3D_v6_1.75mm_Universal.stl, e3d_v6_all_metal_hotend.scad, e3d_v6_hot_end.scad, frame_gantry.dxf, frame_gantry_and_y_carriage.dxf, hot_ends.scad, main.scad, nnscr_config.scad]
2015-10-11 changed carriage and extruder to fit the e3d hotend
    [e3d_v6_hot_end.scad, hot_ends.scad, main.scad, nnscr_config.scad, wade.scad, x-carriage.scad]
2015-10-11 added better pcb spacer for arduino mount
    [main.scad, pcb_spacer.scad]
2015-10-13 changed material to mdf and fixed arduino mount (was mirrored)
    [dust_filter.stl, electronics.scad, frame_gantry.dxf, frame_gantry_and_y_carriage.dxf, frame_left.dxf, frame_right.dxf, frame_stays.dxf, nnscr_config.scad]
2015-10-19 changed material to thicker mdf and some small changes
    [atx_brackets.stl, atx_long_bracket.stl, atx_short_bracket.stl, bar_clamps.stl, cable_clip_AB.stl, cable_clip_AD.stl, cable_clip_CA.stl, cable_clips.stl]
2015-10-26 changed material and removed bottom z switch
    [atx_brackets.stl, atx_short_bracket.stl, frame_base.dxf, frame_gantry.dxf, frame_gantry_and_y_carriage.dxf, frame_left.dxf, frame_right.dxf, frame_stays.dxf]
